Junshu111/junshu-camera/models/README.md

# 外壳与打印模型参考

单位为毫米。STL 用于导入后重新切片；Blender、FreeCAD、STEP 和网格坐标源用于理解、修改。已有网格源不等于全参数化 CAD，改变尺寸后应重新核对内部空间、配合和壁厚。

## 先选择正确版本

| 目录 | 内容 | 如何使用 |
| --- | --- | --- |
| core-20261028 | V27 主壳和共用件、V28 内部件、V29 镜头件、A_down 拨杆；50 个 STL、完整 3MF、Blender 装配、坐标和打印预设 | 原始结构基线，不要求把50对象都装上或全部重印 |
| battery-v31 | 对应48×40×20 mm电池的09盒体和07面盖；源网格、STL、3MF与安装图 | 成套替换基线旧07／09；其他鞋键等按说明复用 |
| usb-c-g2 | 修正方向的30滑盖、31胶粘托架、32后挡，另带原04底盖备用 | 替换基线充电口小件；不要使用已经过时的G1安装图，33键不用于G2 |
| lever-v30 | F1—F3圆盘、T1—T3卡环及试配说明 | 六个是试配候选，不要全部安装或默认选最厚档 |
| hood-n3-v1 | 七件式外置折叠遮光斗，装配源与逐步说明 | 可选附件，实际卡紧、弹性、开合和寿命待打印验证 |
| bottom-clips | 四只底盖连接扣的单独补印盘 | 维修补件，与基线同源，不替代完整机壳 |
| exterior-concept-r01 | FreeCAD可见性修正工程、STEP和重建脚本 | 仅外观概念：125×78×42 mm，无完整内部适配或可打印结构，不是上面106 mm高方盒的替换壳 |

**48×40×20 mm 电池与 G2 充电口采用后续替换件时，原总包的旧07／09与30—33并不是最终组合。** 原版说明保留历史上下文，先按这张替换表选件，再查看各目录说明。

## 文件与检查范围

- 原主壳参考外形125×78×106 mm；与4.3英寸顶部屏幕、Pi3B+、CM2及原控件的尺寸相关。
- 3MF 是原交付的拓竹 X2D / 0.4 mm喷嘴 / PETG Matte 示例，不是所有材料的默认配方。部分含原机器的切片 G-code；先以项目方式打开、检查对象并为自己的打印机重新切片，不直接发送内嵌G-code。
- V30试配例为0.12 mm层高；主结构等示例为0.16 mm。材料、机器、方向或缩水不同，间隙与手感可能不同。
- 来源记录中的切片或几何检查通过，不代表新读者的实物装配、胶接、电池线根余量、供电或长期寿命通过。遇阻先停止该步骤，核对零件版本和实际尺寸。
- Blender装配可能含硬件代理和示意对象；可打印件以相应STL和零件清单为准，不能把装配场景里的每个网格都当作打印件。

从 [core-20261028/原版安装说明.md](core-20261028/原版安装说明.md)理解基础顺序，再按本页替换表和 [battery-v31/安装说明.md](battery-v31/安装说明.md)处理后续电池件。G2当前提供文字选件与干装说明，没有把G1旧图改名冒充G2教程。

所有选入文件的来源、SHA与改动说明见根目录 SOURCE-MANIFEST.json；自有模型和图文用 CC BY 4.0，署名“自制相机项目”。视频制作场景和动画未包含在这里。
