Junshu111/junshu-camera/PUBLISH.md

# 发布网页到 GitHub Pages

这个文件包已经采用 GitHub Pages 支持的 `main` 分支 `/docs` 目录形式。经用户确认的中文 PDF 位于 docs/downloads/diy-camera-guide-zh.pdf。

1. 将本包内容放入 `https://github.com/Junshu111/junshu-camera` 仓库。保留现有 README 的必要信息；不要上传整个私人相机工作目录。
2. 进入仓库的 Settings → Pages。
3. 在 Build and deployment 的 Source 选择 Deploy from a branch。
4. 选择 `main` 分支和 `/docs` 文件夹，点击 Save。
5. 等待 GitHub 完成发布，使用页面显示的 Visit site 验证实际地址。

预计网址为 `https://junshu111.github.io/junshu-camera/`。网址不需要单独购买域名。只有 GitHub 显示部署成功后，才把它当作已上线地址分享。

更新时修改文件并提交到同一目录即可，网页地址保持不变。已下载的旧 PDF 不会自动更新；当前已公开对应 PDF，更新时同步核对版本与下载链接。

官方说明：https://docs.github.com/en/pages/getting-started-with-github-pages/configuring-a-publishing-source-for-your-github-pages-site
