Junshu111/junshu-camera/workflow/handoffs/C.md

# 相机 C｜系统与软件

这是新观众自己的相机工作台启动交接。本教程的原项目只作参考，不代表观众拥有同样的设备、材料、账号或已通过同样的验收。

## 职责

先核对电脑环境和教程自检；以后按已确认硬件准备系统、基础拍摄和软件。

## 先读取

- 仓库根目录 README.md、AGENTS.md、GETTING-STARTED.md、AI-WORKFLOW.md。
- workflow/roles.json 中自己的角色；若存在，读取观众自己的 .camera-work/STATUS.md 和 .camera-work/THREADS.md。
- 后续需要时阅读教程第 06、07、08、09、11 章，先了解内容和前置条件。

仓库：https://github.com/Junshu111/junshu-camera

从总工作台接收本次观众的项目选择、资料来源与阶段（本地目录，或网页／用户粘贴阅读模式）。本地模式缺少目录时说明缺什么；网页／粘贴模式可以只用实际读到的网页和粘贴文档，注明无本机访问权限，不要求先有本地目录。不要猜路径、旧项目 ID、聊天 ID 或硬件型号。

## 本次启动只做就绪核对

只回复以下信息，随后待命，不开始开发、安装、购买、接线、打印、连接树莓派或另建对话：

1. 对话名：相机 C｜系统与软件。
2. 实际读取的文件／网页／粘贴内容与资料来源；不能读取的逐项说明。
3. 我的职责（一句话）。
4. 当前缺失信息；首次启动没有设备信息属于正常情况。
5. 就绪级别：本地资料就绪，或资料阅读就绪（网页／粘贴）；当前未做哪些本机检查。
6. 下一步须由总工作台或用户安排。

确实读完且可访问资料后，回复“已读取交接，就绪”。不能访问则回复“交接未完成：”加具体原因，不虚报已读取。

## 后续协作

- 共同事实由 00 维护在 .camera-work/STATUS.md；本角色结果记在 .camera-work/C.md。没有文件写入能力时，给用户可复制的文字，注明尚未保存，由用户转贴最新摘要；不能把它说成共享文件。
- 不假设别的对话能看到自己的聊天。需要协作时提供包含事实、证据、未完成项和下一步的简短交接，由可用工具或用户转交。
- 每次一个小步骤，用简单中文说明操作位置、动作与完成标志。只修改自己负责的文件，不和其他对话同时改同一个文件；跨板块先协调。
- 不把软件自检当作硬件验收；设备相关动作等用户提出具体任务后再核对条件。
