Junshu111/junshu-camera/models/lever-v30/原版试配说明.md

# V30 拨杆空程校准包

制作完成于 2026-10-28；目录日期保留本轮开始日期。基于已能正常下拨的临时 01 **A_down** 盒架和圆盘，保留现有开关、外拨杆、主壳及止挡位置。本轮只打印 6 个可替换小件，同一盘完成，每组每次只安装其中一件。

**打印入口：[01_X2D_PETG_Matte_V30_Lever_Fit_Calibration.3mf](01_X2D_PETG_Matte_V30_Lever_Fit_Calibration.3mf)**

[六件对照与测试顺序图](images/V30-六件标记与测试顺序.png) · [实际顶层刀路及刻线核对](images/actual-top-layer-paths.png)

## 两组分别解决什么

你确认「内部圆盘跟着转，但金属开关杆暂时不动」，因此主要空程在 **26 圆盘叉口与金属开关杆的接触处**。F 组用于缩小这处空程；T 组用于调整转轴前后窜动，两组分开测试，便于知道哪个改动有效。

照片红圈的两块白色凸台属于 **25 盒架的固定止挡**。它们不直接接触金属杆。计算显示，同时沿照片向下移动 0.2 mm，会让下拨终点约提前 1°，回位端反而多约 0.8° 余程，因此这次保留已验证可触发的止挡，改真正拾取金属杆的叉口接触面。

## 实体标记与档位

| 编号 | 形状 | 简单标记 | 改动 |
| --- | --- | --- | --- |
| T1 | U 形卡环，28 号件 | 1 条短刻线 | 总厚 1.40 mm，接近原卡环，作为参照 |
| T2 | U 形卡环，28 号件 | 2 条短刻线 | 总厚 1.52 mm |
| T3 | U 形卡环，28 号件 | 3 条短刻线 | 总厚 1.64 mm |
| F1 | 带叉口的圆盘，26 号件 | 1 条短刻线 | 下叉内接触面向槽内推进 0.10 mm，槽宽 7.30 mm |
| F2 | 带叉口的圆盘，26 号件 | 2 条短刻线 | 下叉内接触面向槽内推进 0.15 mm，槽宽 7.25 mm |
| F3 | 带叉口的圆盘，26 号件 | 3 条短刻线 | 下叉内接触面向槽内推进 0.20 mm，槽宽 7.20 mm |

T 组刻线在一只开口腿上；F 组在轴套平面上，靠方孔外侧。都是浅刻，不加凸起。图中各零件从标记面展示；与装机照片可能左右相反，实际安装继续沿用原方向。F 组的上叉、方孔、转轴配合和外轮廓均保持原形，圆盘整组不会移位或反向。

## 打印

已用本机 Bambu Studio 按 **拓竹 X2D、0.4 mm 喷嘴、Bambu PETG Matte、纹理 PEI 板**实际切片并重新打开。单盘六件估计 **约 41 分钟、6.46 g**，本次切片支撑耗料为 **0 g**。保留工程摆向、100% 比例和内置设置即可。

- 层高 **0.12 mm**，首层 0.20 mm；4 层墙、20% gyroid、外侧 brim 5 mm。
- 三只卡环的 G-code 顶层高度已核对，分别为 **1.40 / 1.52 / 1.64 mm**，不会被切成同一厚度。
- 成功使用过的支撑参数仍嵌在工程中：普通自动／紧贴／35°，Z 0.24 / 0.24、XY 0.35、界面 3 / 2 层及 0.5 mm 间距。保持“开启支撑”即可，当前摆放并未实际生成支撑。
- 两组均平放打印。圆盘内方孔有约 8.34 mm 的最长桥接刀路线段，这个数值不是保证桥接质量；取件后检查孔内有无明显垂料再装方轴。关键接触面和刻线均不靠拆支撑得到。
- 卡环有 brim，取件后只清除薄薄的贴床外缘，别把 U 形两腿削薄或剪断。
- 在打印板中 T1 / T2 / T3 位于一排，F1 / F2 / F3 位于另一排；每排按 1 → 3 排列。对象名也含编号与尺寸，取下后按刻线识别。

## 怎么测试

先断开电池供电，保留原来已能正常下拨的 **A25 盒架、112-B1 开关和原安装方向**。本包不是给 B 上拨诊断盒架使用的，也不需要把开关本体翻转。两组试样不是同时全装入。

1. **先测 F 组。** 保持现在的 U 形卡环不变，依次用 F1、F2、F3 替换原圆盘；每次重新装好原外拨杆、衬套和卡环。
2. 轻拨几次，观察圆盘和金属杆是否更早一起动作，松手能否自行完全回位。静止时不能持续压着金属杆，也不能需要手推才能回位。若某档已经卡住，换回较松一档，不强拉。
3. 选择“虚位更小、拨动顺、自动回位完整”的 F 档。F3最紧，但不保证最合适。F 档之间只差 0.05 mm，打印误差可能让相邻两档手感接近；如接近，反馈为“差不多”即可。
4. **固定刚选好的 F，再测 T 组。** 依次换 T1、T2、T3，观察转轴前后窜动是否变少，同时确认转动没有变涩、回弹仍完整。卡环只装一只，不叠加。
5. 最后对选中的组合试拍，确认静止不误触发、一次下拨能正常拍摄、松手能复位。新件尚未实物试装，计算结果不能代替这一步。

建议直接这样反馈：

> F2 + T2：虚位明显减小；拨动顺；松手全部回位；正常触发。F3 会卡／T3 太紧。

如果三档之间差不多，也请说是哪一组。保留原圆盘和原卡环作为对照，不要削原止挡来补偿。

## 复用与检查范围

保留现有 **A25 盒架、27 外柄 B 或 C、29 轴套、112-B1 开关及原螺母、盒架锁件、主壳**。这里只用一个 F 和一个 T，其他作为尺寸对照件。已经打印好的 V28、V29 镜头和内部固定件继续使用。

六件都已做单连通／闭合网格、原接口保持、A 全行程静态避让、B/C 外柄、已知开关本体、V27/V28/V29 场景与规划线束检查；导出 3MF 与源 STL 的网格、摆向和比例复核通过。族图金属杆代理中，三档在名义休止位均无预压，接触逐档提前，原固定止挡接管角保持。但实际金属杆截面、开关自然回位角、PETG 打印公差、力和磨损未测，尤其不能保证 F3 的实物间隙。

最终 3MF SHA256：`b3f65afaebf328b8c55c4b22fd70b07c8084ed2d6abcf7248b7a80073f101cd6`。本轮没有改主壳、旧制造工程、树莓派或打印机，也没有删除任何文件。
