Junshu111/junshu-camera/LICENSES/README.md

# 许可范围

Copyright © 2026 自制相机项目。

- 本项目自有的软件源码、脚本和测试：仓库根目录 [MIT License](../LICENSE)。允许使用、修改和再分发，保留版权与许可声明。
- 本项目自有的三维模型、网格、打印工程、图示、教程文字和工作流模板：[CC BY 4.0](CC-BY-4.0.txt)。允许分享和改作，包括商业用途；署名“自制相机项目”，链接原仓库及许可，并说明修改。
- 软件内 New Cam 图形素材随图文采用 CC BY 4.0。使用素材不代表原项目维护者为衍生项目背书。
- 第三方文件按各自原有许可：二维码库 Nayuki QR Code generator 的 MIT 声明保留在软件 vendor 目录；字体 Inter 和 Noto Sans SC 的原许可保留在 docs/assets/fonts/。
- 运行依赖如 PyQt5、Pillow、Picamera2、libcamera、gpiod、系统服务及建模／切片软件没有随本仓库重新授权，使用时遵守它们各自的许可。

模型和源代码以现状提供。资料中的数字检查、特定设备使用反馈与读者自己的装配、用电、打印和长期可靠性检查分开记录。

许可来源：[MIT 官方文本](https://opensource.org/license/mit)、[CC BY 4.0 官方许可](https://creativecommons.org/licenses/by/4.0/)。
