Junshu111/junshu-camera/project-reference/requirements/README.md

# 原项目需求与决策参考

本目录公开原相机的PRD、问答和决策记录，帮助理解如何从目标形成制作步骤。它们是历史设计记录，不是观众已经确认的需求，也不表示其中每项功能已经实现。

当前技术参考以根目录 RELEASE-CONTENTS.md、software/README.md 和 models/README.md 为入口；是否通过验收以对应版本的证据和观众自己的实测为准。PRD里的静态界面只说明设计方向。

公开副本只调整本机绝对路径和交接链接，原始本地文档保留。观众自己的目标、预算和进度由相机00及A维护，避免直接照搬原样机的全部需求。
