Junshu111/junshu-camera/models/usb-c-g2/README.md

# G2 充电口方向修正版

先用当前目录的3MF和stl/内文件。30为配套滑盖、31为胶粘托架、32为加宽U形后挡；04底盖仅备用，已有正确底盖可复用，不必重印。不使用基线旧31、旧32和33固定键，也不使用G1安装图的方向。

先正常关机并断开电源，在未装电池、未通电条件下核对实际Type-C母口尺寸、朝向、尾线空间和底盖孔位；先干装、确认方向与线根无挤压，再按适合实际材料的胶接方法固定。胶不能进入接口或接触电池、导线裸露端。

原G2数字刚性装配和切片已核对；实物干装、真实线通过和胶接强度仍需用户自己的验证。source/保留修正后的装配源；本次公开整理没有改变网格。
