Junshu111/junshu-camera/project-reference/requirements/decisions.md

# A 板块决策记录

当前 PRD：v0.1.4；更新日期：2026-10-13（Asia/Shanghai）。

原则：用户最新确认优先；初稿建议、工作表示例、概念图和其他板块建议，不自动成为用户决定。确认状态、优先级和验证状态分别记录。新增条目不重排已有编号。

## 1. 既有确认决定

来源统一为原项目制作者于 2026-10-13 的最新消息；保留关键原话以便核对。

| 决定编号 | 确认内容与来源摘录 | 对应要求 | 影响 |
| --- | --- | --- | --- |
| A-DEC-001 | “先做一台自己能带出门，拍街景、旅行和生活记录的完整相机”。 | A-REQ-001、002 | A1 不重复询问用途；产品目标以日常完整相机为准。 |
| A-DEC-002 | 对“2×是否同时裁切取景和最终保存照片”回答“是的”。 | A-REQ-009 | 预览与保存采用一致的裁切范围；当时未决定是否额外留原图；本轮Q11已明确不额外保存未裁切独立照片，RAW像素规则现由Q38记录为后续全幅加裁切信息；当前不执行RAW拍摄。 |
| A-DEC-003 | “大部分的操作我希望通过触屏来完成”。 | A-REQ-004 | 手动参数的入口优先讨论触屏；不默认需要实体旋钮。 |
| A-DEC-004 | “保留至少两个实体按键”，分别是执行拍照的快门键和用于开关机的开机键。 | A-REQ-005、006、007 | 至少两个键，不锁定恰好两个；本轮Q23和Q29进一步确认电源动作及拉杆形态，详见新增决定。 |
| A-DEC-005 | “前期仅通过micro sd即可”，并希望简单操作。 | A-REQ-010 | 不加入前期无线或 USB 直连导出要求；存照布局及安全取卡流程需验证。 |
| A-DEC-006 | 体积、重量、续航“初稿先把这个问题留着”，看完后再回复，并要求再提问一次。 | A5，A-OPEN-006 | 原定读稿后再问；本轮Q25至28已回答，提醒完成，数值仍待实测。 |
| A-DEC-007 | 本对话只负责 A 产品定义与 PRD；其他问题整理为供总工作台分配的任务。 | 协作边界 | 只维护 A-PRD；不实现相机软件、接线、采购或结构。 |
| A-DEC-008 | “除了本身的工作文件之外，再给我一份容易阅读的PDF”。 | 交付要求 | 保存 PRD.md、decisions.md、handoff.md，并生成 PRD-阅读版.pdf。 |
| A-DEC-009 | 最初要求每轮只讨论一个关键问题，区分用户确认、建议和待实测，按 A1 至 A8 完善。 | 初始工作方式 | v0.1 按此执行；提问节奏现由 A-DEC-010 调整，状态区分继续沿用。 |
| A-DEC-010 | 最新原话：“我大概看了，我还是希望在这个对话框里，把问题都统一给我，我一条条按顺序来回答。” | 最新工作方式 | 一次在对话展示完整清单，按 A1 至 A8 连续编号，允许逐条或分批回答；初步阅读不视为批准全部草案。 |

## 2. 历史确认的延续与冲突处理

历史来源：2026-10-13 PRD 工作表中的“已经确定的内容”，以及截至 2026-10-12 的迁移包 handoff、ui-and-design 和 decision-log。这里延续既有确认，没有将其标成用户本轮重新确认。

| 记录编号 | 历史内容 | 当前处理 |
| --- | --- | --- |
| A-HIST-001 | 单摄、当前阶段拍照片，不开发录像。 | 延续 A-REQ-003。 |
| A-HIST-002 | 顶部屏幕；左手托底、右手快门；胸前或略低位置持机。 | 延续 A-REQ-011、012；姿势与结构仍需实测。 |
| A-HIST-003 | 主要拍竖幅；横拍上方预览、下方控制。 | 延续 A-REQ-013、014；比例与安装方向未锁定。 |
| A-HIST-004 | 1×、2×、更多入口；2×曾作为数字裁切候选。 | 延续 A-REQ-008；最新 A-DEC-002 正式确认裁切用于取景与保存。 |
| A-HIST-005 | 快门拉杆及三只旋钮的外观偏好。 | 保留历史参考；结合 A-DEC-003、004，不列为首台必需。本轮Q29选择拉杆；三只旋钮仍不是必需，不因附图自动加入。 |
| A-HIST-006 | 喜欢 C-P1、D-P2 两个方向，未最终选定。 | 保留为 E 的外观参考，不冻结机壳样式和尺寸。 |
| A-HIST-007 | Pi 3B+、CM2、触摸屏和 PB721 已有；系统、屏幕与触摸有基础测试。 | 测试起点；不是最终硬件选型，也不是整机已通过证明。 |

旧候选项按本轮答案更新：默认自动曝光和默认自动白平衡不直接采用，改为恢复上次模式；手动参数、回显、相机内回看和异常反馈已由Q14、20、21、36确认。A-CAND-001/002由A-REQ-025/026替代其默认假设；A-CAND-003至006转入A-REQ-027、034至039、051。LUT留后续；无线导出继续不纳入前期要求。候选编号保留作历史追踪，不另维护重复需求正文。

## 3. v0.1.2保存的36项回答

以下36条来源均为本对话本批用户回答，日期2026-10-13。每条保留原话，不将用户提出的硬件候选参数当作已经实测。

| 决定编号 | 原题 | 用户原话 | 记录状态 | 关联需求 |
| --- | --- | --- | --- | --- |
| A-DEC-011 | Q1 | 需要时再开机。 | 已确认 | A-REQ-015 |
| A-DEC-012 | Q2 | 手持为主，可以选择背带或放包里 | 已确认 | A-REQ-016 |
| A-DEC-013 | Q3 | 静止街景，户外帮朋友拍照、人物照片为主。 | 已确认 | A-REQ-017 |
| A-DEC-014 | Q4 | 白天户外，紧接着室内。夜晚暂时不考虑，考虑传感器大小还是太小了 | 已确认使用取舍；未将原因写成实测结论 | A-REQ-018 |
| A-DEC-015 | Q5 | 桌上的食物、近距离人像、对街建筑。这些都是需要的。 | 已确认场景；具体距离待样片 | A-REQ-019 |
| A-DEC-016 | Q6 | 手机查看、电脑编辑 | 已确认 | A-REQ-020 |
| A-DEC-017 | Q7 | 3:4、1:1、16:9、9:16 | 已确认 | A-REQ-013、A-REQ-021 |
| A-DEC-018 | Q8 | 自然还原。后期成熟后再制作lut风格 | 已确认；LUT后续 | A-REQ-022、A-REQ-053 |
| A-DEC-019 | Q9 | 色彩、清晰度更重要 | 已确认；样片待评价 | A-REQ-022 |
| A-DEC-020 | Q10 | JPEG+RAW，JPEG、RAW。有三个选择 | 已确认需求；能力待验证 | A-REQ-023 |
| A-DEC-021 | Q11 | 不需要额外保留未裁切。给用户的体验是，所见即所得。如果用户选择了2x则出来就是裁切的，如果选择1x，则是不裁切的。 | 已确认目标；RAW与比例规则需细化 | A-REQ-009、A-REQ-024 |
| A-DEC-022 | Q12 | 恢复上次的模式 | 已确认 | A-REQ-025 |
| A-DEC-023 | Q13 | 恢复上次的模式。如果用户设置了自动白平衡，开机后就是自动白平衡，如果是自定义，则自定义。 | 已确认 | A-REQ-026 |
| A-DEC-024 | Q14 | 曝光补偿、快门、ISO／增益、白平衡，这些都需要。 | 已确认需求；范围待核实 | A-REQ-027 |
| A-DEC-025 | Q15 | 是的，需要。 | 已确认需要限制；阈值待定 | A-REQ-028 |
| A-DEC-026 | Q16 | 按一次拍一张。暂时不考虑连拍 | 已确认 | A-REQ-006 |
| A-DEC-027 | Q17 | 网格（暂不做）、直方图（必须）、曝光锁定（必须）、自拍延时（必须） | 后三项明确P0；网格首台不做 | A-REQ-029、A-REQ-030、A-REQ-031、A-REQ-055 |
| A-DEC-028 | Q18 | 再开机，倍率、曝光、白平衡、屏幕亮度，这些都要保留。 | 已确认 | A-REQ-032 |
| A-DEC-029 | Q19 | 是的 | 已确认：启动后直接取景 | A-REQ-033 |
| A-DEC-030 | Q20 | 最好可以选择。默认是短暂显示照片3s再恢复。这个需要在设置菜单里，给用户选择。 | 已确认；其他选项待细化 | A-REQ-034 |
| A-DEC-031 | Q21 | 需要。用户可以触屏选择观看当前张，也可以选择同时看到多张。并且触屏可以进行放大缩小（双手指），屏幕也有多选择功能，多选择后，可以一次性删除多张照片。默认删除按键，是用户点击预览单张照片时，会在触屏里出现。如果用户在同时观看多张照片，只有多选按钮。 | 已确认；双格式分组与删除规则需细化 | A-REQ-035、A-REQ-036、A-REQ-037 |
| A-DEC-032 | Q22 | 提示忙碌。 | 已确认；不登记排队拍摄 | A-REQ-038 |
| A-DEC-033 | Q23 | 双击短按后在屏幕确认。长按3s也可以直接关机。不过关机时，如果正在保持照片，则需要等保存完成后，再关机。 | 已确认；按上下文将“保持照片”理解为“保存照片” | A-REQ-007、A-REQ-039 |
| A-DEC-034 | Q24 | 两则都需要。 | 已确认：Mac和Windows | A-REQ-010 |
| A-DEC-035 | Q25 | 我希望内置电池。暂时测试时使用充电宝，当机子测试到一定程度后，开始做结构时，再考虑电池位置。 | 内置目标已确认；测试电源与结构阶段区分 | A-REQ-041 |
| A-DEC-036 | Q26 | 目前有一些concept图片（附图）。不过这需要完成基础功能测试，到结构设计时再最后确认。 | 参考图已提供；尺寸与结构待验证 | A-REQ-043 |
| A-DEC-037 | Q27 | 待称重和握持比较 | 已回答：待实测 | A-REQ-044 |
| A-DEC-038 | Q28 | 目前考虑电池大小是5v3a的2500毫安电池。内置在相机里。实际续航待测试。 | 候选规格；容量单位及基准电压待核实；续航待测 | A-REQ-042、A-REQ-045 |
| A-DEC-039 | Q29 | 我希望是拉杆形态。如果设计成熟，我希望把录制视频和拍照分开。拉杆形态是拍照，按键是录制视频。不过暂时先不考虑视频录制。 | 拉杆已确认；视频控制后续 | A-REQ-003、A-REQ-005、A-REQ-006、A-REQ-046、A-REQ-054 |
| A-DEC-040 | Q30 | 是的。希望不要拆机壳取卡，只打开卡槽盖就能取出 microSD | 已确认 | A-REQ-040 |
| A-DEC-041 | Q31 | 零件没有上线。不过大部分打算使用拓竹的3D打印机（X2D）来完成大部分零件，元器件则可以网上或者华强北购买。 | 按上下文记录为未设零件预算上限；型号原样保留待核实；时间未指定 | A-REQ-047 |
| A-DEC-042 | Q33 | 待测试。当然越快越好。 | 已回答：目标待实测 | A-REQ-048 |
| A-DEC-043 | Q34 | 要能抓瞬间 | 体验目标已确认；时间待实测 | A-REQ-049 |
| A-DEC-044 | Q35 | 没有概念，是不是要取决于读卡速度？这个可以通过测试后再研究。 | 已回答：待实测；分解编码与写卡等环节 | A-REQ-050 |
| A-DEC-045 | Q36 | 可以通过声音来提示。保存成功和保存失败分别有对应的音效。并且画面也需要提示对应的异常状态。 | 已确认 | A-REQ-051 |
| A-DEC-046 | Q37 | 应该先检查开机、拍照、保存、导出和关机，这些基本功能，然后才外出拍照测试。 | 已确认验收顺序 | A-REQ-052 |

## 4. v0.1.3新增的8项回答

以下为本对话最新回答，日期2026-10-13。Q32确认首台必做范围，Q38进一步给出实际RAW拍摄延后的具体例外；两项结合记录，不把一般范围确认覆盖具体延期。

| 决定编号 | 原题 | 用户原话 | 记录状态 | 关联需求 |
| --- | --- | --- | --- | --- |
| A-DEC-047 | Q32 | 是的 | 已确认其余当前功能为首台P0；Q38的RAW实际拍摄延后作为明确例外。 | 当前首台范围；A-REQ-023、053至057、059 |
| A-DEC-048 | Q38 | 我希望是后一种。但是我觉得这有点难度。我的决定是，UI界面保留raw的选择，但是现阶段不执行raw的拍摄功能，还是以jpg为主。只是提供这个选择，但是用户选择后，会显示raw暂不支持。 | 首台仅实际拍JPEG；保留RAW相关提示入口。后续偏好全幅RAW加裁切信息，兼容性待后续验证。 | A-REQ-009、023、056、057 |
| A-DEC-049 | Q39 | 是的 | 已确认1×仍允许所选比例裁切。 | A-REQ-009、021、024 |
| A-DEC-050 | Q40 | 曝光ev为0，白平衡为自动，倍率是1x，比例是9:16（竖屏拍摄），保存格式默认jpg | EV 0、自动WB、1×、9:16、JPEG五项已确认。曝光模式自动/手动尚未说明，新增45；不将本题标为漏答。 | A-REQ-021、025、026、058 |
| A-DEC-051 | Q41 | 分别是3s，5s，10s | 已确认三个选项：3s、5s、10s。默认和取消等细节未决定。 | A-REQ-031 |
| A-DEC-052 | Q42 | 是的，预览时只展示jpeg，删除时两个文件同时删除。删除时仅提示「是否确认删除」即可，无需提示raw删除这件事。 | 当前JPEG删除先确认“是否确认删除”；双格式逻辑照片、JPEG预览与配对删除规则留给后续RAW。 | A-REQ-037、059、060 |
| A-DEC-053 | Q43 | 如果出现保存失败，则停止关机，并提示用户报错。 | 已确认取消本次关机，保持开机并报错。 | A-REQ-039、051 |
| A-DEC-054 | Q44 | 需要关闭回显，秒数可以设置3s和10s两个选择。 | 已确认关闭、3s、10s三个选项；默认继续为3s。 | A-REQ-034 |

A的交互建议：RAW和JPEG+RAW入口点击后提示“raw暂不支持”，保持JPEG为有效格式且清楚显示。入口和不执行RAW由用户确认；有效格式如何显示由C细化，不把建议当作用户新增原话。未创建或测试RAW文件。

## 5. v0.1.4新增确认

本对话2026-10-13最新两条用户消息；原话完整保留。触屏拍照是新增需求，不从概念图倒推用户已确认。

| 决定编号 | 原题或来源 | 用户原话 | 记录状态 | 关联需求 |
| --- | --- | --- | --- | --- |
| A-DEC-055 | Q45 | 是的。自动曝光 | 首次自动曝光已确认；EV 0沿用Q40，后续仍恢复上次模式。 | A-REQ-025、058 |
| A-DEC-056 | 用户主动新增 | 我刚想到，拍照功能在触摸屏里也需要有。可以在触摸屏上直接点击拍照。 | 首台P0；触屏拍照与实体拉杆并存，共用既有拍摄规则；布局由C细化。 | A-REQ-006、038、061 |

Q45关闭；首次自动曝光由建议转为确认。触屏入口不替代实体拉杆；同一拍摄功能已有的自拍、忙碌、保存及回显规则均适用于两种入口。A只记录要求，不启动实现。

## 6. 当前开放决定与提醒

| 编号 | 最新状态 | 下一步与影响 |
| --- | --- | --- |
| A-OPEN-001 | Q1已确认需要时开机。 | 关闭使用习惯问题；启动数值转A-VER-002。 |
| A-OPEN-002 | 白天户外、室内，静止街景和朋友人像；食物、近人像、对街建筑均需要。 | 场景已明确；实际距离与清晰度转A-VER-001。 |
| A-OPEN-003 | 四比例、1×比例裁切、2×范围和JPEG阶段明确；后续RAW全幅加裁切信息。 | 38/39已回答；RAW真实拍摄延后，不阻塞当前JPEG验证；输出尺寸仍看样片。 |
| A-OPEN-004 | 首次自动曝光、EV 0、自动WB、1×、9:16、JPEG；自拍选项及触屏/拉杆双拍照入口明确。 | Q45已答，首次默认关闭；锁定、直方图、自拍/回显细节后续统一提问，控制范围由B测。 |
| A-OPEN-005 | 回显关闭/3s/10s、删除确认、后续双格式配对、失败取消关机已确认。 | 42至44不再待答；双格式验证为后续，当前JPEG图库和关机先验证。 |
| A-OPEN-006 | 内置电池目标已明确；候选电源参数、尺寸、重量、续航未冻结。 | D核电池标注，E/B/D实测；不重复当作用户漏答。 |
| A-OPEN-007 | Mac、Windows与卡槽盖取卡已明确；microSD共卡、分区和读取方案未定。 | 由总工作台安排B/C/D/E验证；不要求用户预选文件系统。 |
| A-OPEN-008 | Q32已确认其余当前功能首台P0；Q38明确实际RAW与双格式拍摄延后。 | 关闭A6范围问题；占位提示仍P0，JPEG阶段先行，当前不做项继续保留。 |
| A-OPEN-009 | 抓瞬间已明确，启动与再拍时间待测；声音和屏幕异常反馈已明确。 | 分项性能、音频、可靠性验证；之后确定数值目标。 |

A-REM-001：2026-10-13已在清单第25至28题再次提问，并收到本轮回答，提醒状态为**完成**。体积/重量/续航目标仍待实测，不把提醒完成当作指标完成。已有答案、原话和来源见questions.md。

## 7. 版本与变更

| 版本 | 日期 | 本轮变化 | 确认与验证状态 |
| --- | --- | --- | --- |
| 聊天初稿 | 2026-10-13 | 形成容易阅读的用途、流程、功能和验收方向；当时未保存为正式文件。 | 多数功能是本对话建议。 |
| v0.1 | 2026-10-13 | 首次保存 A 板块工作文件；整合用途、2×、触屏、两个实体键和 microSD 确认；分开历史偏好、建议与验证任务；生成阅读版 PDF。 | 待制作者审阅；A1-Q01 待回答；未完成 A1 至 A8，未开展整机验证。 |
| v0.1.1 | 2026-10-13 | 按最新要求新增 questions.md，完整展示 37 项问题，更新讨论方式与便携提醒；同步阅读版 PDF。 | 产品需求编号与内容不变；全部问题待回答，A1 至 A8 未完成。 |
| v0.1.2 | 2026-10-13 | 录入原37题中的36项回答；保留原14个需求号并追加至55项；新增验收和验证任务；记录3项明确P0、8项关键待答及附图参考；更新阅读版。 | 未获A6完整范围确认；RAW与若干规则待细化；未新增实机验证，仍非v1.0基线。 |
| v0.1.3 | 2026-10-13 | 保存Q32及Q38至44的8项回答；确认当前功能P0、实际RAW延后；补1×比例裁切、首次默认、自拍、删除、失败关机和回显；60条需求、26项验收、9项待分配验证任务；同步PDF。 | 第45题仅补首次曝光模式；性能/控制/供电等仍待测，尚非最终基线，未新增硬件验证。 |
| v0.1.4 | 2026-10-13 | 首次自动曝光获确认；新增触屏拍照P0并保留拉杆，统一自拍/忙碌/保存/回显规则；61条需求、27项验收、10项待分配验证；同步PDF。 | 1至45题均已回答，详细交互与实测仍待完善；未实施相机功能或新增硬件测试。 |

后续每轮记录：用户原话或来源、日期、对应编号、变更原因、对拍摄流程/软硬件/结构/验收的影响。其他板块提议先记录为变更建议，由制作者确认后更新正式需求。
