Junshu111/junshu-camera/project-reference/requirements/questions.md

# A 板块统一问题与回答记录

清单版本：Q-v0.4；配套PRD：v0.1.4；日期：2026-10-13（Asia/Shanghai）。

## 当前状态

- 第1至45题全部已回答；本轮另收到用户主动新增的触屏拍照要求，单独记录，不占用下一题编号。
- Q32确认其余当前功能首台P0；Q38明确实际RAW拍摄延后，仅保留提示入口。
- Q45已确认首次自动曝光，EV 0沿用Q40；本轮已发出问题无待答项，详细交互和实测目标仍需完善。
- 数值暂缺、待样片或待测试属于已回答的“待实测决定”，不标成用户漏答。
- A-REM-001便携再次提问与回答已完成；尺寸、重量、续航依然待测。
- 所有答案来源为本对话，日期2026-10-13；概念图不作为功能或尺寸确认。
- 细节待完善清单集中保存在下文，之后按A1至A8统一在本对话提问。

## 本轮原题答案

### 1. A1-Q01

问题：出门时希望相机一直开机、需要时再开机，还是两种都常用？

> 用户原话：需要时再开机。

状态：已确认。

关联：A-REQ-015。

### 2. A1-Q02

问题：平时主要怎样携带：手持、挂背带，还是放包里？

> 用户原话：手持为主，可以选择背带或放包里

状态：已确认。

关联：A-REQ-016。

### 3. A1-Q03

问题：常拍静止街景，还是走动的人、宠物和转瞬即逝的画面？

> 用户原话：静止街景，户外帮朋友拍照、人物照片为主。

状态：已确认。

关联：A-REQ-017。

### 4. A1-Q04

问题：主要在哪些光线下拍：白天户外、室内、夜晚？可以按常用程度排序。

> 用户原话：白天户外，紧接着室内。夜晚暂时不考虑，考虑传感器大小还是太小了

状态：已确认使用取舍；未将原因写成实测结论。

关联：A-REQ-018。

### 5. A1-Q05

问题：经常拍的主体距离大概多远？可以用“桌上的食物、近距离人像、对街建筑”等例子描述。

> 用户原话：桌上的食物、近距离人像、对街建筑。这些都是需要的。

状态：已确认场景；具体距离待样片。

关联：A-REQ-019。

### 6. A2-Q01

问题：照片主要用来手机查看、电脑编辑、发社交平台，还是打印？

> 用户原话：手机查看、电脑编辑

状态：已确认。

关联：A-REQ-020。

### 7. A2-Q02

问题：希望有哪些照片比例？例如竖幅 2:3、3:4、1:1，以及相应横幅；可以多选。

> 用户原话：3:4、1:1、16:9、9:16

状态：已确认。

关联：A-REQ-013、A-REQ-021。

### 8. A2-Q03

问题：默认照片希望自然还原，还是带某种固定色调或风格？

> 用户原话：自然还原。后期成熟后再制作lut风格

状态：已确认；LUT后续。

关联：A-REQ-022、A-REQ-053。

### 9. A2-Q04

问题：画质最在意哪几项：清晰度、色彩、肤色、暗部、高光还是噪点？

> 用户原话：色彩、清晰度更重要

状态：已确认；样片待评价。

关联：A-REQ-022。

### 10. A2-Q05

问题：JPEG 是否够用，还是希望同时保存 RAW？RAW 作为需求意向记录，支持情况待核实。

> 用户原话：JPEG+RAW，JPEG、RAW。有三个选择

状态：三入口保留；最新Q38已将实际RAW和双格式拍摄延后。

关联：A-REQ-023、057。

### 11. A2-Q06

问题：2×拍摄时，除了已确认的裁切照片，是否还要额外保存未裁切原图？

> 用户原话：不需要额外保留未裁切。给用户的体验是，所见即所得。如果用户选择了2x则出来就是裁切的，如果选择1x，则是不裁切的。

状态：目标确认；Q39明确1×允许比例裁切，Q38明确后续RAW偏好与当前延期。

关联：A-REQ-009、A-REQ-024。

### 12. A3-Q01

问题：开机后的曝光模式希望默认自动，还是恢复上次使用的模式？

> 用户原话：恢复上次的模式

状态：已确认。

关联：A-REQ-025。

### 13. A3-Q02

问题：白平衡希望默认自动，还是恢复上次设置？

> 用户原话：恢复上次的模式。如果用户设置了自动白平衡，开机后就是自动白平衡，如果是自定义，则自定义。

状态：已确认。

关联：A-REQ-026。

### 14. A3-Q03

问题：希望在触屏上手动调哪些参数：曝光补偿、快门、ISO/增益、白平衡，或其他？实际可调范围待核实。

> 用户原话：曝光补偿、快门、ISO／增益、白平衡，这些都需要。

状态：已确认需求；范围待核实。

关联：A-REQ-027。

### 15. A3-Q04

问题：自动曝光时，是否需要限制最高 ISO 或最慢快门？可以先写需要，数值后定。

> 用户原话：是的，需要。

状态：已确认需要限制；阈值待定。

关联：A-REQ-028。

### 16. A3-Q05

问题：快门只需要按一次拍一张，还是希望按住连拍？

> 用户原话：按一次拍一张。暂时不考虑连拍

状态：已确认。

关联：A-REQ-006。

### 17. A3-Q06

问题：网格、直方图、曝光锁定、自拍延时中，哪些希望加入？可以逐项标“必须、可选、暂不做”。

> 用户原话：网格（暂不做）、直方图（必须）、曝光锁定（必须）、自拍延时（必须）

状态：后三项明确P0；网格首台不做。

关联：A-REQ-029、A-REQ-030、A-REQ-031、A-REQ-055。

### 18. A3-Q07

问题：关机再开机后，希望保留哪些设置？例如倍率、曝光、白平衡、屏幕亮度。

> 用户原话：再开机，倍率、曝光、白平衡、屏幕亮度，这些都要保留。

状态：已确认。

关联：A-REQ-032。

### 19. A4-Q01

问题：是否希望开机完成后直接进入取景界面？

> 用户原话：是的

状态：已确认：启动后直接取景。

关联：A-REQ-033。

### 20. A4-Q02

问题：拍完一张后，希望立即恢复取景、短暂显示照片再恢复，还是由你手动返回？

> 用户原话：最好可以选择。默认是短暂显示照片3s再恢复。这个需要在设置菜单里，给用户选择。

状态：已确认；Q44已补关闭/3s/10s选项。

关联：A-REQ-034。

### 21. A4-Q03

问题：相机内回看希望做到哪一步：不需要、只看上一张、浏览所有照片？需要放大或删除也可以注明。

> 用户原话：需要。用户可以触屏选择观看当前张，也可以选择同时看到多张。并且触屏可以进行放大缩小（双手指），屏幕也有多选择功能，多选择后，可以一次性删除多张照片。默认删除按键，是用户点击预览单张照片时，会在触屏里出现。如果用户在同时观看多张照片，只有多选按钮。

状态：已确认；Q42补删除确认及后续双格式配对规则。

关联：A-REQ-035、A-REQ-036、A-REQ-037。

### 22. A4-Q04

问题：上一张还在保存时，再按快门应提示“忙碌”并暂不拍，还是记住这次按压、随后继续拍？

> 用户原话：提示忙碌。

状态：已确认；不登记排队拍摄。

关联：A-REQ-038。

### 23. A4-Q05

问题：关机希望怎样操作：长按电源键直接正常关机，还是短按后在屏幕确认？其他方式也可以说明。

> 用户原话：双击短按后在屏幕确认。长按3s也可以直接关机。不过关机时，如果正在保持照片，则需要等保存完成后，再关机。

状态：已确认；按上下文将“保持照片”理解为“保存照片”。

关联：A-REQ-007、A-REQ-039。

### 24. A4-Q06

问题：microSD 导出的照片主要需要在哪种电脑上读取：Mac、Windows，还是两者都要？

> 用户原话：两则都需要。

状态：已确认：Mac和Windows。

关联：A-REQ-010。

### 25. A5-Q01

问题：出门是否接受外置充电宝和连接线，还是希望电源全部装进机身？

> 用户原话：我希望内置电池。暂时测试时使用充电宝，当机子测试到一定程度后，开始做结构时，再考虑电池位置。

状态：内置目标已确认；测试电源与结构阶段区分。

关联：A-REQ-041。

### 26. A5-Q02

问题：体积希望接近哪台熟悉的相机或物件？没有参照可以先写“看实物后定”。

> 用户原话：目前有一些concept图片（附图）。不过这需要完成基础功能测试，到结构设计时再最后确认。

状态：参考图已提供；尺寸与结构待验证。

关联：A-REQ-043。

### 27. A5-Q03

问题：重量希望接近哪台相机，或能接受多重？没有概念可以写“待称重和握持比较”。

> 用户原话：待称重和握持比较

状态：已回答：待实测。

关联：A-REQ-044。

### 28. A5-Q04

问题：一次出门，希望持续使用多久才需要充电？可以用“几小时、半天、一天”描述，实际续航待测。

> 用户原话：目前考虑电池大小是5v3a的2500毫安电池。内置在相机里。实际续航待测试。

状态：候选规格；容量单位及基准电压待核实；续航待测。

关联：A-REQ-042、A-REQ-045。

### 29. A5-Q05

问题：实体快门希望采用普通按键，还是保留此前参考中的拉杆形态？

> 用户原话：我希望是拉杆形态。如果设计成熟，我希望把录制视频和拍照分开。拉杆形态是拍照，按键是录制视频。不过暂时先不考虑视频录制。

状态：拉杆已确认；视频控制后续。

关联：A-REQ-003、A-REQ-005、A-REQ-006、A-REQ-046、A-REQ-054。

### 30. A5-Q06

问题：取 microSD 时，是否要求不拆机壳、只打开卡槽盖就能取出？

> 用户原话：是的。希望不要拆机壳取卡，只打开卡槽盖就能取出 microSD

状态：已确认。

关联：A-REQ-040。

### 31. A5-Q07

问题：新增零件和机壳是否有预算上限或希望完成的时间？暂时没有限制可以留空。

> 用户原话：零件没有上线。不过大部分打算使用拓竹的3D打印机（X2D）来完成大部分零件，元器件则可以网上或者华强北购买。

状态：按上下文记录为未设零件预算上限；型号原样保留待核实；时间未指定。

关联：A-REQ-047。

### 32. A6-Q01

问题：是否把其余已确认功能都作为首台必做？直方图、曝光锁定、自拍延时已按你的“必须”记为P0；如有可以延后的功能，请指出。

> 用户原话：是的

状态：已确认其余当前功能为首台P0；Q38的RAW实际拍摄延后作为明确例外。

关联：当前首台范围；A-REQ-023、053至057、059。

### 33. A7-Q01

问题：从按开机键到可以拍照，最多愿意等多久？没有概念可以先测现状。

> 用户原话：待测试。当然越快越好。

状态：已回答：目标待实测。

关联：A-REQ-048。

### 34. A7-Q02

问题：按快门到真正拍到画面，能接受多少延迟？可以先描述“要能抓瞬间”或“可以短暂等待”，再用实测定值。

> 用户原话：要能抓瞬间

状态：体验目标已确认；时间待实测。

关联：A-REQ-049。

### 35. A7-Q03

问题：拍完一张后，多久能拍下一张才可接受？可以给大致时间，也可以先测。

> 用户原话：没有概念，是不是要取决于读卡速度？这个可以通过测试后再研究。

状态：已回答：待实测；分解编码与写卡等环节。

关联：A-REQ-050。

### 36. A7-Q04

问题：是否同意以下建议：没真正保存成功就不提示成功；卡满、保存失败或相机未就绪时，清楚提示原因和可做的操作？

> 用户原话：可以通过声音来提示。保存成功和保存失败分别有对应的音效。并且画面也需要提示对应的异常状态。

状态：已确认。

关联：A-REQ-051。

### 37. A8-Q01

问题：是否同意用“按约定场景带出门完整拍一轮，加上开机、拍照、保存、导出、关机逐项检查”验收第一台？还有什么必须通过的使用场景，可以补充。

> 用户原话：应该先检查开机、拍照、保存、导出和关机，这些基本功能，然后才外出拍照测试。

状态：已确认验收顺序。

关联：A-REQ-052。

## v0.1.3补问与回答

### 38. A2-Q07

问题：选2×时，RAW必须只保存裁切区域像素，还是接受保留全幅原始数据、通过裁切信息让软件默认显示2×？

> 用户原话：我希望是后一种。但是我觉得这有点难度。我的决定是，UI界面保留raw的选择，但是现阶段不执行raw的拍摄功能，还是以jpg为主。只是提供这个选择，但是用户选择后，会显示raw暂不支持。

状态：首台仅实际拍JPEG；保留RAW相关提示入口。后续偏好全幅RAW加裁切信息，兼容性待后续验证。

关联：A-REQ-009、023、056、057。

### 39. A2-Q08

问题：选1×加1:1、16:9等比例时，是否允许按比例裁切？建议1×表示没有额外2×放大，比例裁切仍生效、取景与照片一致。

> 用户原话：是的

状态：已确认1×仍允许所选比例裁切。

关联：A-REQ-009、021、024。

### 40. A3-Q08

问题：没有上次设置的首次开机，曝光、白平衡、倍率、比例和保存格式分别默认什么？后续仍恢复上次设置。

> 用户原话：曝光ev为0，白平衡为自动，倍率是1x，比例是9:16（竖屏拍摄），保存格式默认jpg

状态：本题五项默认已确认，Q45进一步明确首次自动曝光；不将本题标为漏答。

关联：A-REQ-021、025、026、058。

### 41. A3-Q09

问题：自拍延时需要哪些秒数选项？

> 用户原话：分别是3s，5s，10s

状态：已确认三个选项：3s、5s、10s。默认和取消等细节未决定。

关联：A-REQ-031。

### 42. A4-Q07

问题：JPEG+RAW是否在相册算一张照片、删除时同时删两个文件？删除是否再次确认？

> 用户原话：是的，预览时只展示jpeg，删除时两个文件同时删除。删除时仅提示「是否确认删除」即可，无需提示raw删除这件事。

状态：当前JPEG删除先确认“是否确认删除”；双格式逻辑照片、JPEG预览与配对删除规则留给后续RAW。

关联：A-REQ-037、059、060。

### 43. A4-Q08

问题：等待保存后关机时出现保存失败，是否取消这次关机、保留错误提示，待处理后再关机？

> 用户原话：如果出现保存失败，则停止关机，并提示用户报错。

状态：已确认取消本次关机，保持开机并报错。

关联：A-REQ-039、051。

### 44. A4-Q09

问题：拍后回显除了默认3s，还需要关闭回显、其他秒数或手动返回中的哪些选项？

> 用户原话：需要关闭回显，秒数可以设置3s和10s两个选择。

状态：已确认关闭、3s、10s三个选项；默认继续为3s。

关联：A-REQ-034。

## v0.1.4补问与新增要求

### 45. A3-Q10

问题：首次曝光模式是否采用自动曝光、曝光补偿EV 0？后续继续恢复上次模式。

> 用户原话：是的。自动曝光

状态：已确认首次自动曝光；EV 0沿用Q40，后续继续恢复上次曝光模式。此题关闭。

关联：A-REQ-025、058；A-DEC-055。

### 用户主动新增：触屏拍照

> 用户原话：我刚想到，拍照功能在触摸屏里也需要有。可以在触摸屏上直接点击拍照。

状态：已确认首台P0；触屏直接点击拍照，实体拉杆继续保留。两入口共用既有拍摄规则，按钮布局留给C细化，不从概念图擅自指定尺寸。

关联：A-REQ-006、038、061；A-DEC-056。

## 当前待回答清单

本轮已发出的1至45题均已回答，无待答项。下列详细规则尚未完成确认，之后集中在本对话按顺序提问。

## 后续待细化清单

不是本轮漏答，也不填未经确认的默认值。之后在本对话集中按顺序提问；待测项先取得真实证据。

- A2：JPEG输出尺寸与可接受清晰度，先看样片；真实RAW与兼容性为后续。
- A3：直方图类型/显示，曝光锁定范围/触发/解除；自拍默认开关、取消与倒计时；控制单位、范围与自动限制阈值。
- A4：回显计时起点/提前结束，图库详细操作，记忆失效恢复；其他设置是否记忆尚未追加确认。
- A5/A7：体积、重量、续航、温度及启动/触发/再拍速度，按实测后再定数值。
- A8：测试次数、条件、阈值与容差，待功能和样片证据齐备后形成基线。

## 表述解释与未确认建议

- Q23原文“正在保持照片”按上下文解释为正在保存照片，没有新增其他动作。
- Q24“两则”按上下文记录为Mac、Windows两者。
- Q31“零件没有上线”按上下文记录为未设零件预算上限；拓竹X2D按用户原话保留，不声明型号已核实，未获得完成时间。
- Q28的2500“毫安”保留原话，未自动改成已经核实的mAh规格、未推算续航。
- Q39明确1×是不加2×放大，比例裁切仍生效；Q38明确RAW全幅加裁切信息为后续偏好。
- 38至44规则均已回答；实际RAW与双格式当前不执行，配对删除规则留后续。删除提示按原话“是否确认删除”。
- “JPEG”“JPG”在本稿指同一当前格式，不据此限定扩展名。
- RAW和JPEG+RAW两个入口都涉及RAW；当前均作暂不支持提示入口。保持JPEG为有效状态且清楚显示是A的交互建议，未列为用户原话。
- EV 0与曝光模式分别记录；Q40给EV 0，Q45已明确首次自动曝光，当前没有首次模式待答项。
- 新增触屏拍照是同一拍摄功能的第二入口；实体拉杆保留，既有单张、自拍、忙碌、保存反馈和回显规则共用。具体布局由C设计。
