Junshu111/junshu-camera/AI-WORKFLOW.md

# AI 新手引导流程

本文件用于观众明确提出“跟着教程开始做自己的相机”时的引导。普通代码维护、排错、审阅或只读资料请求不自动触发建项目、建对话或搭环境。当前用户指令和本机更高优先级规则始终优先。

目标是先让新手有一个找得到资料、知道下一步的工作台，再逐步做自己的相机。提示词能传递任务，实际执行仍依赖所用应用的工具、访问权限、网络与用户操作。

## 1. 先读资料，第一条回复只做入口选择

读取 README.md、AGENTS.md、GETTING-STARTED.md、本文件、RELEASE-CONTENTS.md 和 workflow/roles.json。只拿到网址时，应实际获取这些文件；不能把看到仓库名字当成读完资料，也不能假设网上的 AGENTS.md 已自动成为当前工作目录的规则。

能读取时，用简单中文回复：这是自己的相机项目，目前可建立工作台、阅读教程，并参考已公开的软件源码与模型；这些参考对应原硬件，读者自己的适配与实测仍需逐步完成。然后展示下面的文字分工图，说明它是计划、不是已创建的结果：

```text
我的自制相机
├─ 相机 00｜总工作台：路线、进度、下一步
├─ 相机 A｜目标与路线
├─ 相机 B｜零件与购买
├─ 相机 C｜系统与软件
├─ 相机 D｜接线与供电
├─ 相机 E｜外观与三维打印
└─ 相机 F｜组装与验收
```

第一条回复只问一个选择：

- A：新建独立项目，并准备这七个对话（推荐）。
- B：在当前项目准备这七个对话。

说明：项目像资料文件夹、对话像分工工作台；选择后再引导。此时不要主动下载到本机、写文件、创建对话或安装软件（只读获取远程文档可以）。已有明确选择则沿用，不重复询问。用户明确要求单对话时也接受，不强制七个对话。

如果无法获取仓库，先坦诚说明未读到哪些资料，并给一个可执行的下一步，例如让用户下载 ZIP、在应用中打开文件夹或粘贴指定文档；不要猜出后续内容或要求账号写入权限。已有本地副本时优先读取，不重复下载。

## 2. 选择项目后，确认资料放在哪里

先识别当前工具：桌面应用、CLI、IDE 或普通聊天；本机或云端；能否读文件、运行命令、管理侧栏项目和对话。分别说明实际能力，不能假定观众拥有作者的插件、账号、模型或本地路径。只读仓库不需要 GitHub 写入授权。

### A：新建独立项目

1. 建议名称“我的自制相机”，由用户决定保存位置。已有同名目录先检查、复用或另选名字，不覆盖。
2. 有可靠的项目创建能力时，在用户选择的范围内使用；没有时，一次只引导用户在侧栏或项目视图中新建／添加本地项目，再关联资料文件夹。界面按钮随版本变化，先核对当前界面；看不到界面时说明大致操作目标，让用户描述实际选项，不编造按钮位置。
3. 资料可通过已有副本、已有 Git 工具克隆，或 GitHub Code → Download ZIP 解压获得。不要为下载公开资料先安装 Git、Node.js 或申请仓库写权限。
4. 在新项目打开相机资料目录。原聊天能移入时按用户选择移入；不能移入时，给新项目的“相机 00”一份连续交接，注明资料位置、项目选择和当前阶段。

### B：使用当前项目

1. 确认当前项目确实存在，并核对它实际可访问的文件夹。尚在项目外时，带用户选择已有项目。
2. 相机资料放在当前项目内独立的 diy-camera 子目录，或复用已存在的正确资料目录。不要改写其他项目根目录的 AGENTS.md、依赖、Git 配置或既有文件。
3. 若相机目录不是项目主目录，要在每个对话启动文字中明确资料位置，并显式读取相机资料目录的 AGENTS.md；不要假设应用会自动发现次级目录中的规则。

### 只有 CLI、IDE 或普通聊天

CLI 用相机资料目录作为工作目录（已有 Codex CLI 时可从该目录启动）；IDE 打开相机资料文件夹；它们不等同于桌面侧栏项目。没有对话管理工具时指导用户手动新建聊天。没有本机文件访问时，采用“网页／粘贴阅读模式”：资料来源记录为实际读到的仓库网页或用户粘贴内容，本机目录可记“用户未提供／当前 AI 无访问权限”。只要必读资料确实读到，就可以建立阅读分工并继续教程；不能宣称本地环境已搭好或已运行命令。用户可以选“先用一个对话”，之后再拆分。

资料可访问后，在资料目录的 .camera-work/ 中保存观众自己的记录：从 workflow/templates/STATUS.md 和 THREADS.md 复制初始模板；已存在则读取并增补，不覆盖。没有写入能力时提供可复制文本，标注尚未保存；由用户把最新摘要转贴给其他对话，不把未保存文本说成共享文件。

## 3. 创建或复用七个用户可见对话

角色的准确名称、职责与章节在 workflow/roles.json；每个角色的启动交接在 workflow/handoffs/00.md、A.md 至 F.md。

用户选择 A 或 B 时，已经选择建立七个对话。先查目标项目中是否已有正确角色的对话，优先复用。只在所选项目中创建缺少的对话；不指定模型、不创建额外 worktree、不批量启动开发。后台子代理不等于用户侧栏中的独立对话。

“相机 00”优先复用当前引导对话（前提是它确实属于目标项目且能访问资料）；无法复用时才创建，避免多一个重复总工作台。其余六个分别使用对应 handoff。当前引导对话复用为 00 时，完成自身就绪核对后继续筹备 A—F，不因“待命”停止；如果另建 00，原引导先完成筹备核对，再把最新摘要和“请接管下一步”交给新 00，明确谁负责继续，避免两个总工作台互相等候。

### 有创建对话的工具

- 使用应用提供的真实项目／对话工具。先列出项目，核对目标，再创建或复用。
- 每个对话的首条消息应包含：自己的角色、仓库 URL、本次观众的资料来源（本地模式填真实绝对路径；网页／粘贴模式填实际 URL 或粘贴文档清单）、所选项目与当前阶段，以及对应 handoff 的完整内容。
- 只允许读取交接并回复就绪，不得开始开发、安装、购买、接线或打印。
- 创建可能异步完成。记录返回的真实 ID／链接，等待或读取对应对话的实际回复，确认交接读取；不无限重试、不把“已排队”写成“已就绪”。

### 没有创建对话的工具

先核对并复用当前 00 和已存在的正确角色，再按 A—F 顺序只创建缺少项；每次只带用户操作一个对话。用户转贴的真实就绪回复也可作为核对证据。告诉用户要用的标题，并给一段可直接发送的启动消息：仓库 URL＋本次已确认的资料来源／阅读模式＋对应 handoff 全文。不要只说“按模板操作”，也不要让新手自己猜占位符。

用户创建后，让该对话按 handoff 回复；用户可把回复转贴给 00。无法直接读取其他对话时，记录为“用户转贴核对”或“待用户确认”，不伪造已查看。本地模式的项目或目录尚未确定时，先完成第 2 步再给带路径的启动消息；网页／粘贴模式不要求本地路径，也不冒充本机已搭建。

## 4. 核对交接，而不是只数聊天数量

按 workflow/templates/THREADS.md 的七行核对：对话是否在所选项目、能否访问同一套资料（本地目录或网页／粘贴文档）、是否读了对应 handoff、职责是否正确。返回成功只能证明创建；实际回复才能证明读完交接。

就绪回复应包含“实际读取的文件、资料位置、一句话职责、缺失信息和当前待命状态”。记录就绪级别：“本地资料就绪”或“资料阅读就绪（网页／粘贴）”。后者可以继续读教程，但本机文件、共享状态和环境自检仍待用户操作。没有硬件信息不妨碍工作台就绪；无法读取基本资料则交接未完成。遇到某个对话卡住，列出那个对话的具体原因，不抹掉其余进度。

共享文件不等于共享聊天记录。本地模式由 00 维护 STATUS.md 和 THREADS.md，A—F 各写自己的 A.md 至 F.md；网页／粘贴模式由 00 提供最新状态摘要，用户转贴，明确未保存到本机。跨角色传递“事实、证据、未完成项、下一步”，避免同时修改同一个文件。只有用户的具体后续任务才触发某个角色工作。

## 5. 从最小的电脑端步骤开始

七个对话就绪后回到 00；用户选单对话后备时直接在当前对话继续，并记明“未建立七对话”。不要让不会创建聊天成为阅读教程的障碍。

按顺序逐个完成，每次只给一个操作和完成标志：

1. 核对电脑系统和资料目录。可用工具只读识别，否则问用户，不能把云端 Linux 当作观众的 Mac／Windows。
2. 确认 docs/index.html 能打开。纯阅读无需安装依赖。
3. 若当前运行位置已有 Python 3，在资料根目录运行 `python3 tools/check_site.py`；Windows 按现有命令可用 `py -3 tools/check_site.py`。记录真实输出。无 Python 时先手动阅读与核对链接，标为“未运行自检”；需要编辑教程时再讨论是否安装，不自动装一套开发工具。
4. 再运行 `python3 tools/check_onboarding.py` 检查引导资料，以及 `python3 -B tools/check_reference.py` 检查软件与模型参考完整性；同样遵守 Python 已有才运行。
5. 回到第 01 章，从“希望拍什么、目前有哪些零件”开始。预算和设备未知时每次问一个问题，不先推荐一篮子购买或执行硬件脚本。

这次启动不连接／写入树莓派，不重写存储卡、不改启动、不接线、不购买、不打印、不发布用户文件。之后用户提出具体硬件任务时，重新核对型号、系统、供电、材料、当前文档和任务边界。

不能把这份教程的 20 页静态自检写成相机软件测试、硬件连接成功或整机验收通过。软件源码与模型位于 software/ 和 models/，先读取各自 README、版本选择与 RELEASE-CONTENTS.md。必须说明参考版的适用条件、未完成实测和下一步；不把原设备限定安装入口当通用安装器，不编造一键适配承诺。

## 6. 每次收尾都能接着做

用中文简洁列出：所选项目、资料位置、对话核对表、电脑端检查结果、尚缺资料、下一步的一个动作。新手只需跟着 00，不必一次操作七个对话。

如果用户暂时离开，写一份简短交接；下次先读自己的状态记录，继续未完成步骤，不重复下载、重复建七个对话或重装环境。

## 能力依据与适用范围

2026-10-31 核对的官方资料：[项目与对话](https://learn.chatgpt.com/docs/projects)、[AGENTS.md 的发现规则](https://learn.chatgpt.com/docs/agent-configuration/agents-md)。它们说明目录、项目上下文和独立聊天的关系；没有保证所有应用都能由一句提示词自动创建项目和七个对话。本流程以当前可用工具为准，并提供手动后备。
