Junshu111/junshu-camera/START-HERE.md

# 第一次来，从这里开始

你可以先让 AI 帮你建立相机工作台，再一步步学习。第一次只准备项目、分工和电脑端阅读环境，不需要先买齐零件。

1. 在 Codex 等 AI 工具中新开一个对话，发送这个仓库链接：
   https://github.com/Junshu111/junshu-camera
2. 打开[网页上的两步入口](https://junshu111.github.io/junshu-camera/setup.html)，点击“复制这段话”，发到同一个 AI 对话里。
3. AI 会先解释分工，并让你选“新项目＋七个对话”或“当前项目＋七个对话”。推荐用单独的新项目，方便以后找资料。你也可以继续用当前项目。
4. 按 AI 的说明完成项目和对话准备，再核对资料能否读取、电脑端自检和第一章。

项目像一个装资料的文件夹；对话像分工不同的工作台。电脑上的文件夹、应用侧栏里的项目和聊天记录是三件不同的事，AI 应帮你把它们对应起来。

## 你接下来会看到什么

```text
我的自制相机（新项目或当前项目）
├─ 相机 00｜总工作台：告诉我下一步，记录进度
├─ 相机 A｜目标与路线：想做什么，预算多少
├─ 相机 B｜零件与购买：认零件，核对购买清单
├─ 相机 C｜系统与软件：电脑环境、系统与拍摄软件
├─ 相机 D｜接线与供电：端子、连接与供电
├─ 相机 E｜外观与三维打印：尺寸、外壳与打印
└─ 相机 F｜组装与验收：安装与最终检查
```

七个对话准备好以后，先在“相机 00｜总工作台”继续。其他对话只读交接、待命，不会同时开始安装或制作。它们不自动共享所有聊天，靠共同记录和简短交接保持一致。只用网页聊天、无法读取电脑文件时，可以按“网页／粘贴阅读模式”先开始，进度由你转贴；这时 AI 不能核实本机环境。

## AI 不能自动创建时

不同应用、版本和权限的功能不同。AI 有创建对话的工具时可以帮你创建；没有时，它会一次带你新建一个对话，并给你对应的启动文字。新建项目也可能需要你在应用里操作。你不必安装额外插件或开放所有文件权限才能开始阅读。

只有一个对话也能先开始：告诉 AI“先用当前对话带我做”，后续再拆分。CLI、IDE 和普通网页聊天的界面可能不同，按当前应用实际支持的方式操作。

## 网址读不了、仓库下载不了

先让 AI 说明具体卡在哪里。可以在 GitHub 仓库页面选择 Code → Download ZIP，解压后在 Codex 中打开该文件夹；如果连 ZIP 都下载不了，就先在[教程网站](https://junshu111.github.io/junshu-camera/)阅读。公开阅读和下载不需要给 AI 你的 GitHub 写入权限。

如果使用只能聊天、不能读取电脑文件的 AI，可以把 README、GETTING-STARTED 和 AI-WORKFLOW 的内容粘贴给它，由它逐步指导你操作。不要把它说出的“已完成”当作电脑已经发生了变化。

## 目前提供到哪里

这一版提供中文教程、AI 协作流程、七角色启动交接和核对模板。另有[相机软件和模型参考资料](RELEASE-CONTENTS.md)，包含本次使用的源码和可编辑／打印文件；适配其他零件和设备仍需逐项核对，无法仅凭网址自动装好相机。可以先建立自己的工作台、了解零件和准备环境，后续按匹配硬件逐项验证。

完整的 AI 执行顺序见 [AI-WORKFLOW.md](AI-WORKFLOW.md)，电脑端操作见 [GETTING-STARTED.md](GETTING-STARTED.md)。PDF 暂不发布，频道视频制作资料不在公开范围内。
