Junshu111/junshu-camera/workflow/templates/STATUS.md

# 我的相机进度

这是待填写的模板，不是 原样机或本机实测结果。首次复制时保留“待确认”；已有状态文件只增补，不覆盖。

- 项目方式：待选择（新项目／当前项目／单对话后备）
- 应用与运行位置：待确认（桌面／CLI／IDE／普通网页聊天；本机／云端）
- AI 实际运行系统与位置：待确认
- 用户电脑系统：待确认（不能从云端系统推断）
- 资料模式：待确认（本地目录／网页或用户粘贴阅读）
- AI 可访问的资料副本目录或网页／粘贴来源：待确认
- 用户电脑资料目录：待确认（未被 AI 实际核实则注明）
- 工作记录目录：资料目录下 .camera-work/
- 相机目标与预算：待确认
- 主板、镜头、屏幕、供电、控件：待确认
- 打印机与本次材料：待确认
- 当前阶段：工作台准备
- 教程自检：未运行
- 硬件实测：未进行
- 已确认的决定：无
- 当前问题：无
- 下一步：完成项目选择、资料访问和对话交接，再做电脑端只读核对

## 工作记录

按日期追加事实、证据、未完成项和下一步。不要保存密码、令牌、Wi-Fi 密码或他人的隐私资料。
