Junshu111/junshu-camera/workflow/templates/THREADS.md

# 对话就绪核对

这是空白记录，不能将模板当作已创建或已就绪证据。

| 角色 | 对话名 | 所属项目与资料来源 | 实际对话链接或 ID | 创建／复用状态 | 交接读取状态 | 核对证据 |
| --- | --- | --- | --- | --- | --- | --- |
| 00 | 相机 00｜总工作台 | 待确认 | 待确认 | 待创建 | 未核对 | 无 |
| A | 相机 A｜目标与路线 | 待确认 | 待确认 | 待创建 | 未核对 | 无 |
| B | 相机 B｜零件与购买 | 待确认 | 待确认 | 待创建 | 未核对 | 无 |
| C | 相机 C｜系统与软件 | 待确认 | 待确认 | 待创建 | 未核对 | 无 |
| D | 相机 D｜接线与供电 | 待确认 | 待确认 | 待创建 | 未核对 | 无 |
| E | 相机 E｜外观与三维打印 | 待确认 | 待确认 | 待创建 | 未核对 | 无 |
| F | 相机 F｜组装与验收 | 待确认 | 待确认 | 待创建 | 未核对 | 无 |

创建工具返回成功，只能记为“已创建”；收到对应对话的真实就绪回复，才能记为“已读取”。手动创建时可根据用户转贴的回复记为“用户转贴核对”。无法查看时保留“待用户确认”。

就绪级别分别标注“本地资料就绪”或“资料阅读就绪（网页／粘贴）”。后者不代表本机环境已搭建；没有文件写入能力时，这张表仅为用户可转贴的文本，标为未保存。
