Junshu111/junshu-camera/docs/assets/camera-detail.png

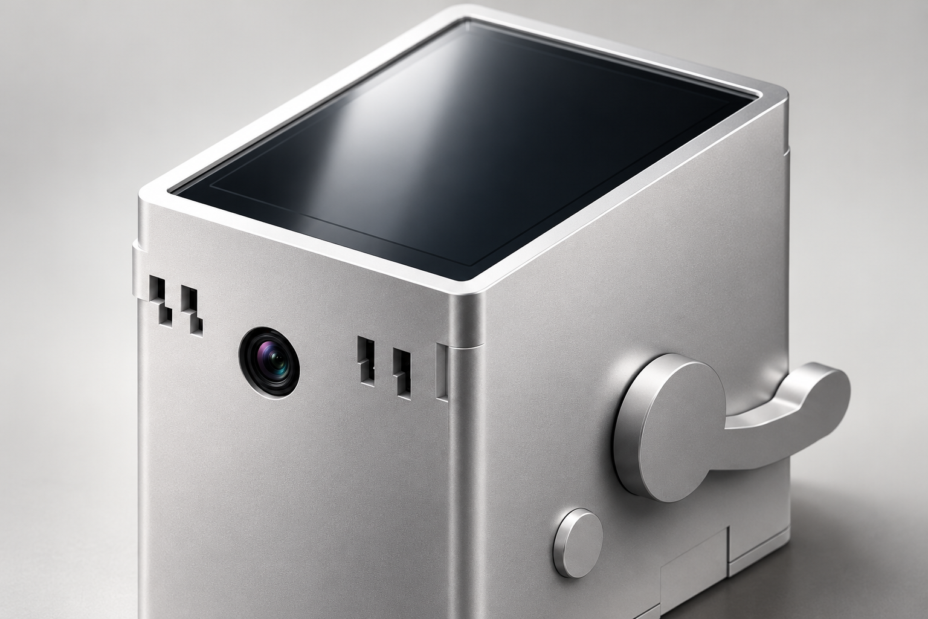
docs/assets/camera-detail.png
