Junshu111/junshu-camera/docs/assets/camera-family-lineart.png

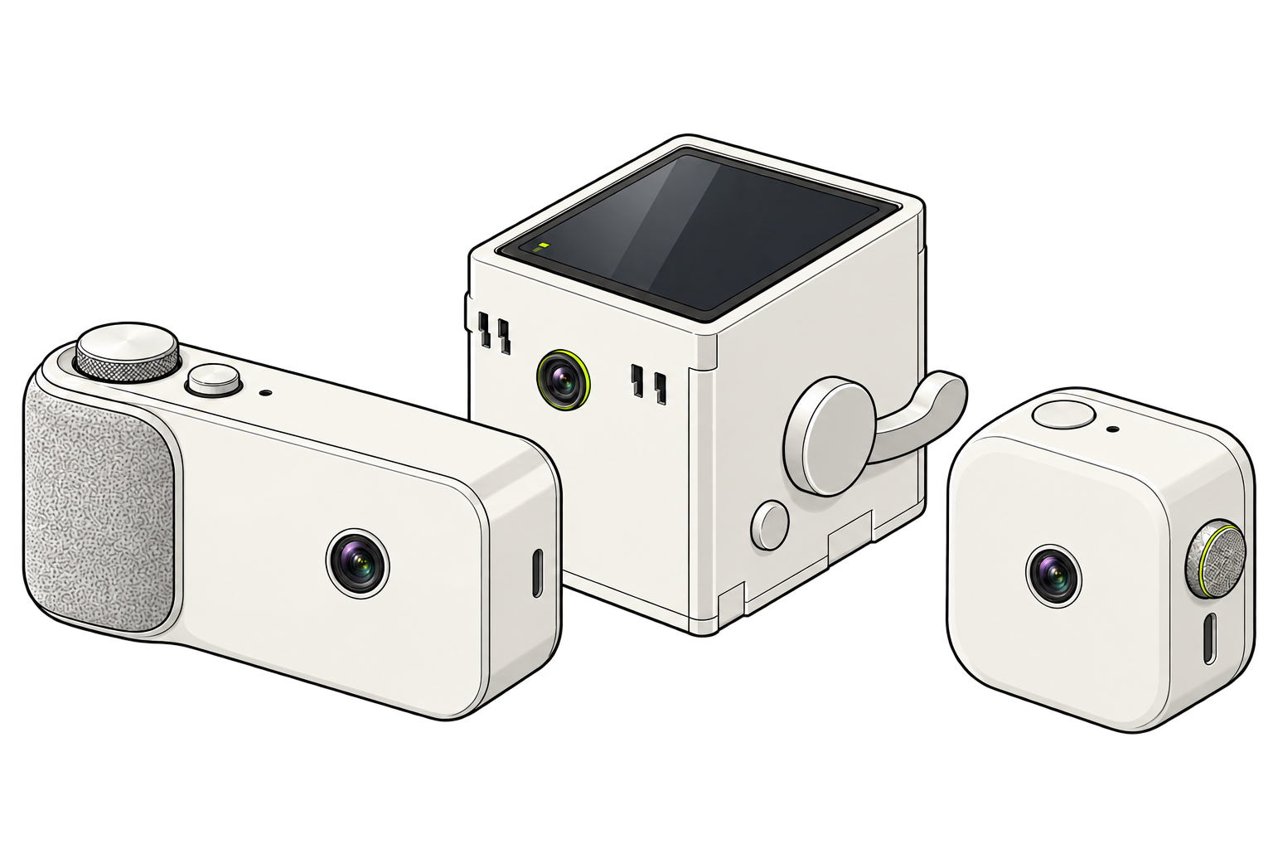
docs/assets/camera-family-lineart.png
