Junshu111/junshu-camera/docs/assets/camera-family.png

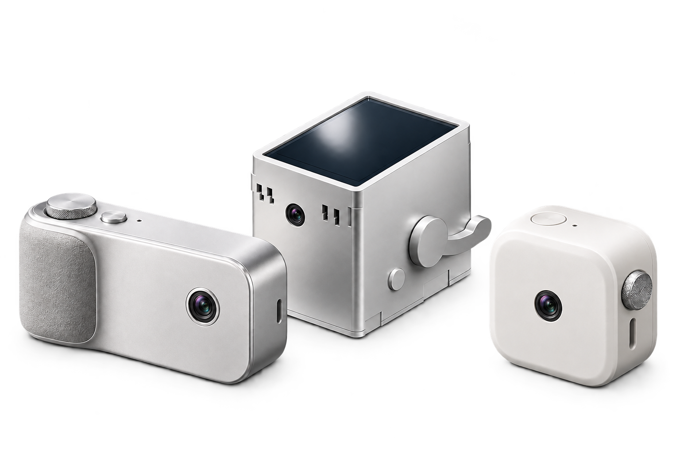
docs/assets/camera-family.png
