Junshu111/junshu-camera/models/core-20261028/illustrations/V29-镜头替换与固定位置.png

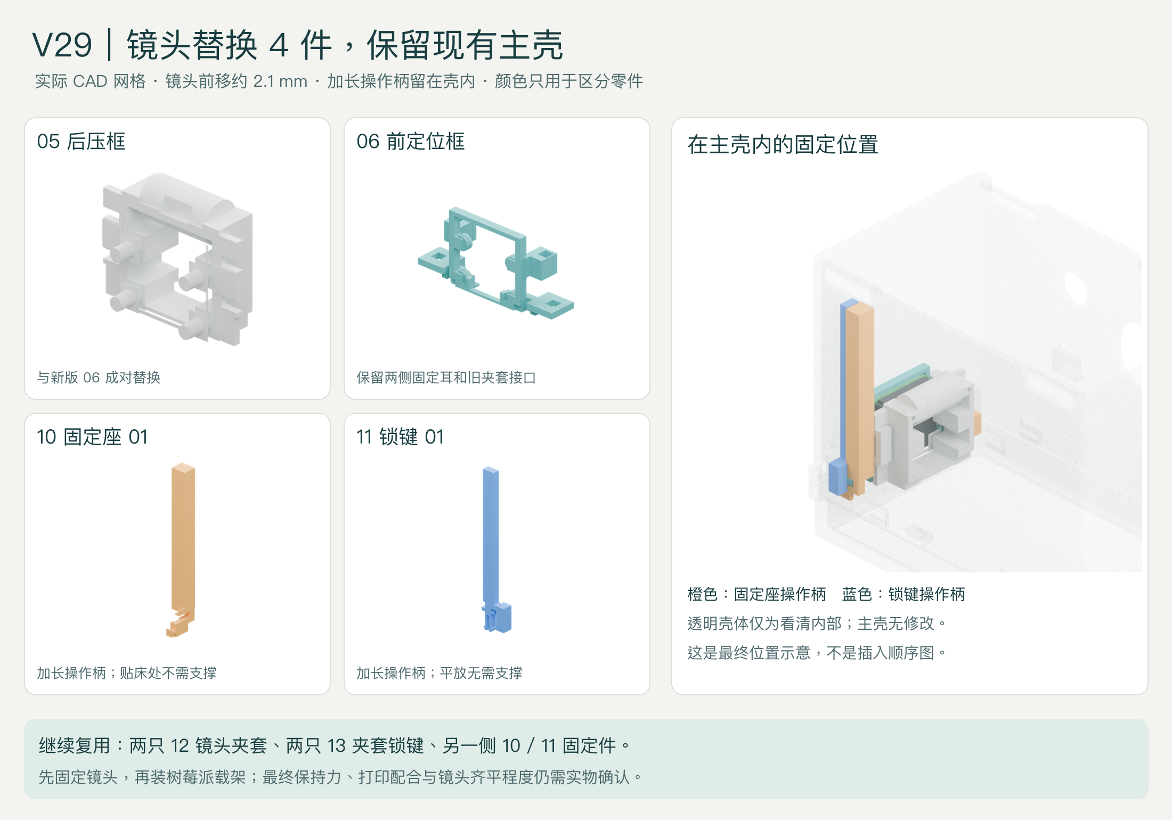
models/core-20261028/illustrations/V29-镜头替换与固定位置.png
