Junshu111/junshu-camera/models/core-20261028/illustrations/当前完整模型-三盘对照.png

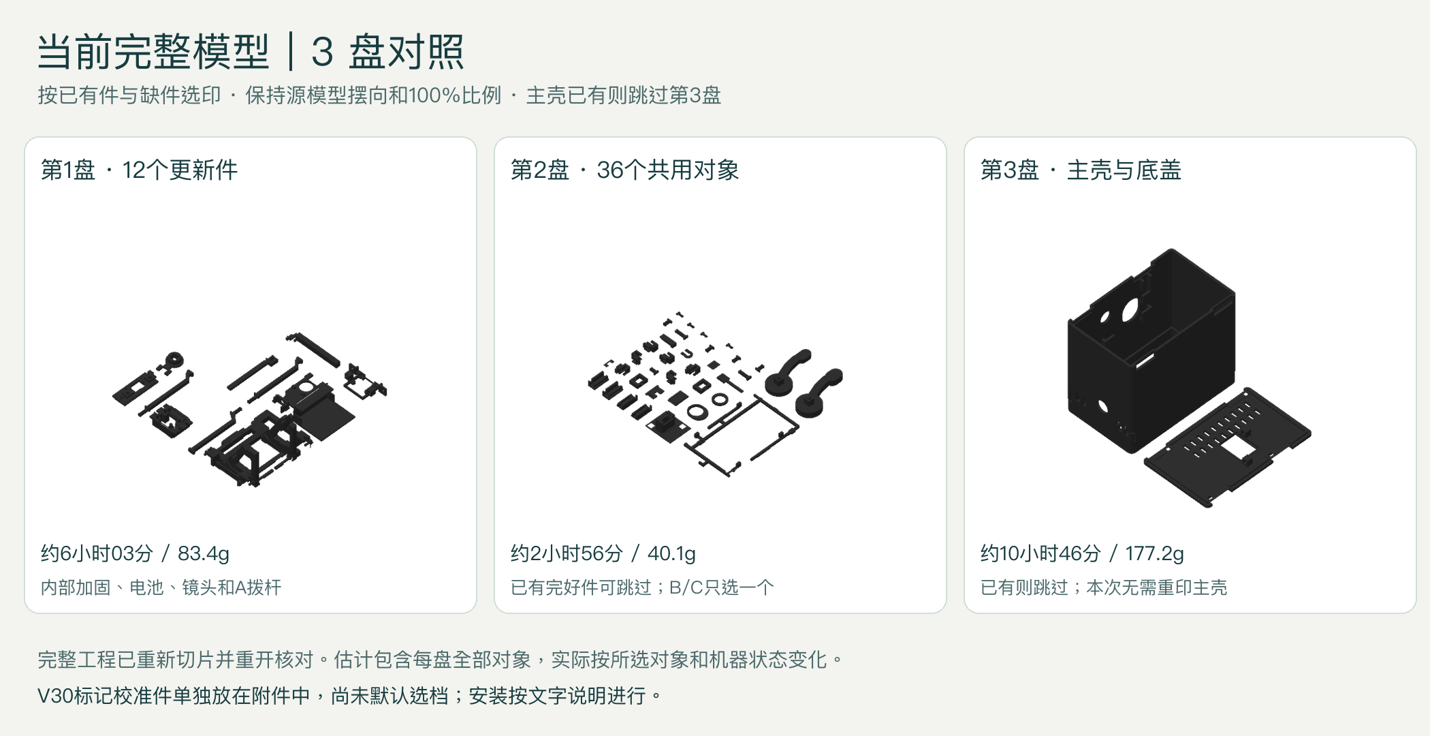
models/core-20261028/illustrations/当前完整模型-三盘对照.png
