Junshu111/junshu-camera/models/lever-v30/images/actual-top-layer-paths.png

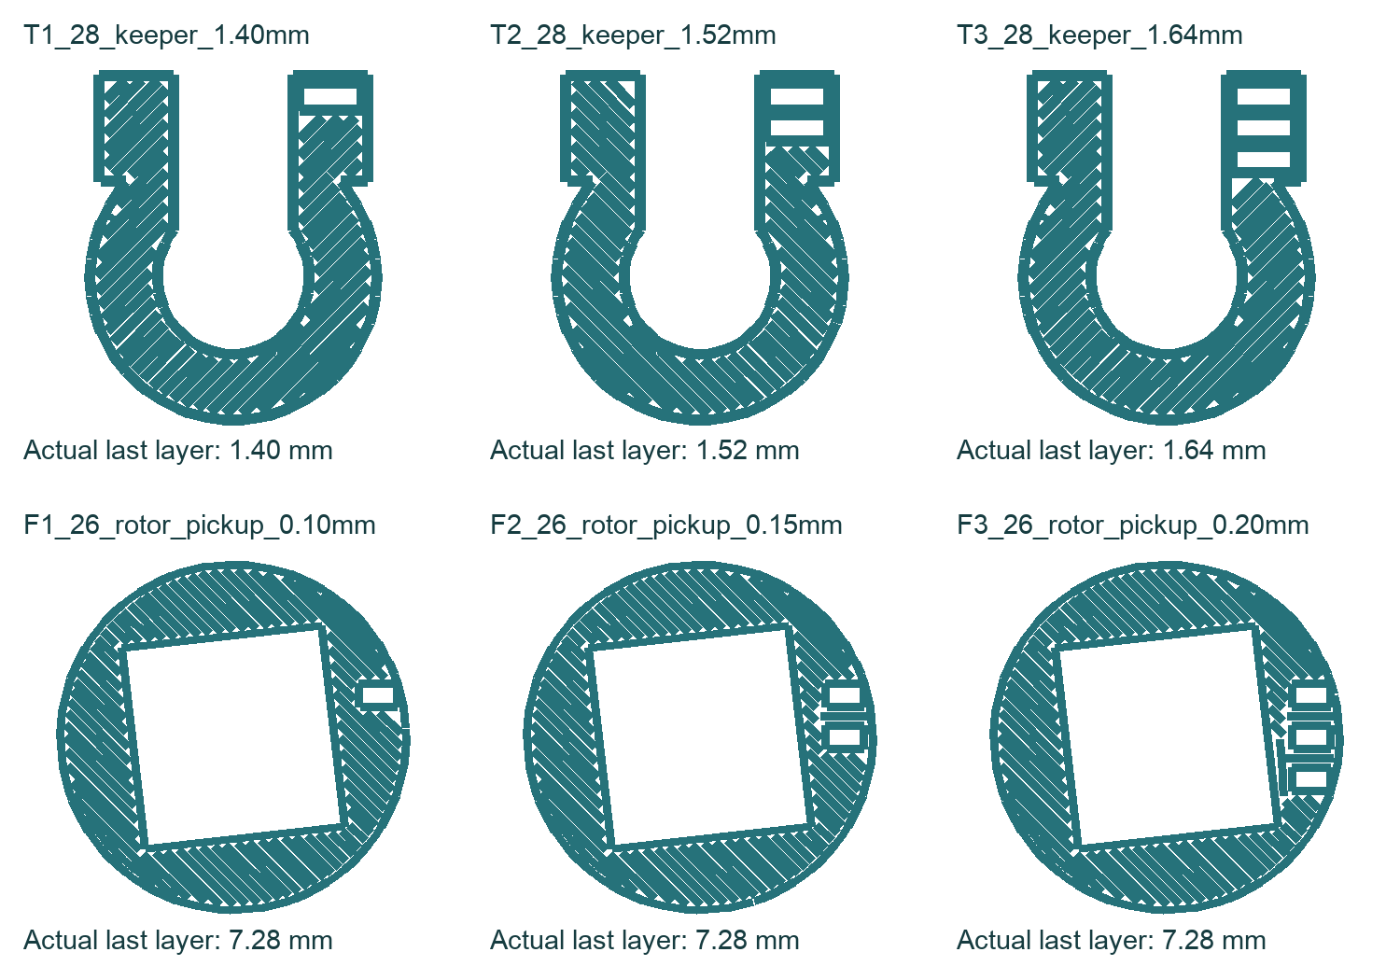
models/lever-v30/images/actual-top-layer-paths.png
