Junshu111/junshu-camera/models/lever-v30/images/V30-六件标记与测试顺序.png

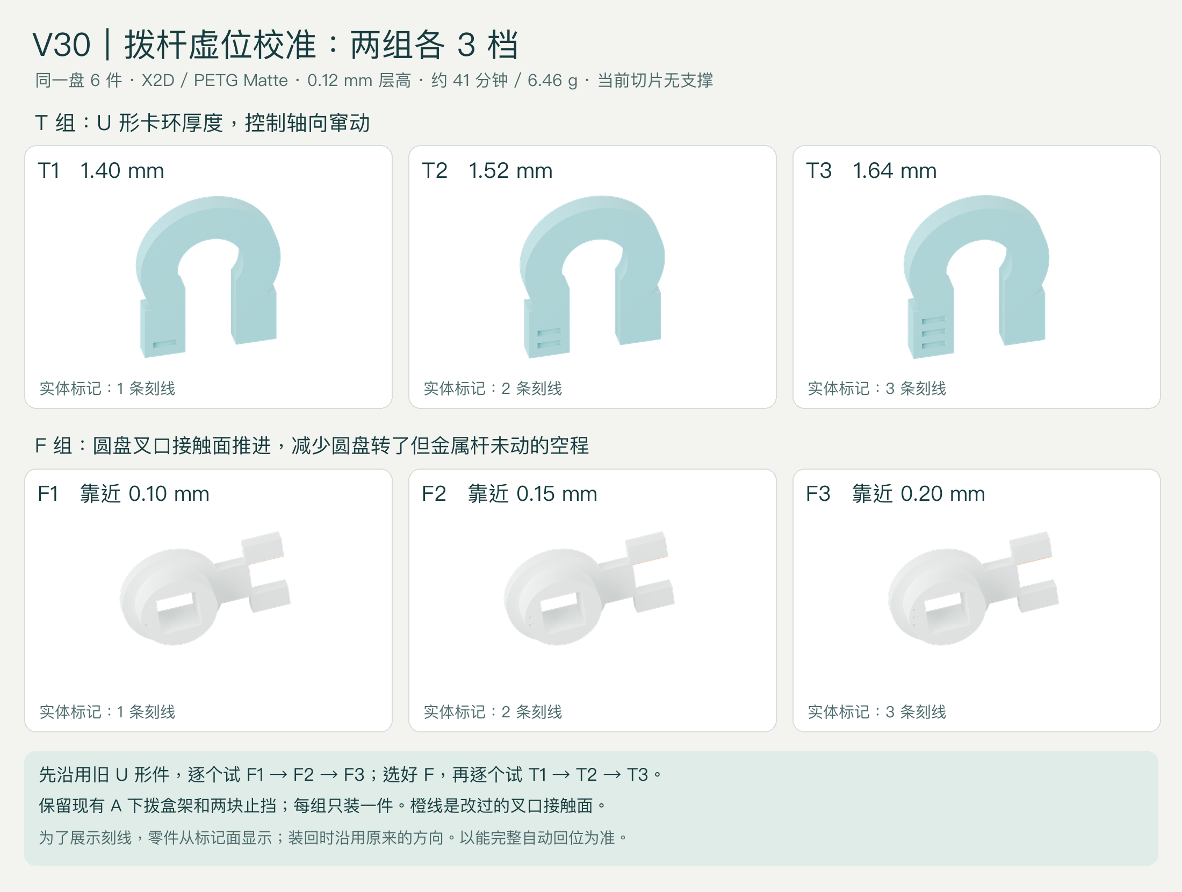
models/lever-v30/images/V30-六件标记与测试顺序.png
