Junshu111/junshu-camera/models/hood-n3-v1/guides/零件与打印清单.csv

编号 | 名称 | 数量 | STL | 打印尺寸mm | 安装朝向
01 | 卡装套框 | 1 | 01_N3_clip_on_frame.stl | 134.20 × 91.60 × 24.80 | 短边铰链对镜头端；较高长边轴线对控件侧
02 | 无控件侧长肩板 | 1 | 02_N3_noncontrol_panel.stl | 122.40 × 49.38 × 7.40 | 高肩对镜头端；铰链凸台朝屏幕
03 | 控件侧长肩板 | 1 | 03_N3_control_panel.stl | 122.40 × 49.38 × 7.40 | 高肩对镜头端；铰链凸台朝屏幕
04 | 镜头侧高板 | 1 | 04_N3_lens_high_panel.stl | 57.60 × 70.40 × 7.40 | 在镜头端；凸轮位于控件侧半边
05 | 长铰轴 | 1 | 05_N3_retaining_axle_L.stl | 5.60 × 114.00 × 3.90 | 镜头端往观看端，细尾先入
06 | 长铰轴 | 1 | 06_N3_retaining_axle_R.stl | 5.60 × 114.00 × 3.90 | 镜头端往观看端，细尾先入
07 | 短铰轴 | 1 | 07_N3_retaining_axle_F.stl | 5.60 × 67.00 × 3.90 | 无控件侧往控件侧，细尾先入
