Junshu111/junshu-camera/models/core-20261028/01_X2D_PETG_Matte_Current_Complete_20261028.3mf

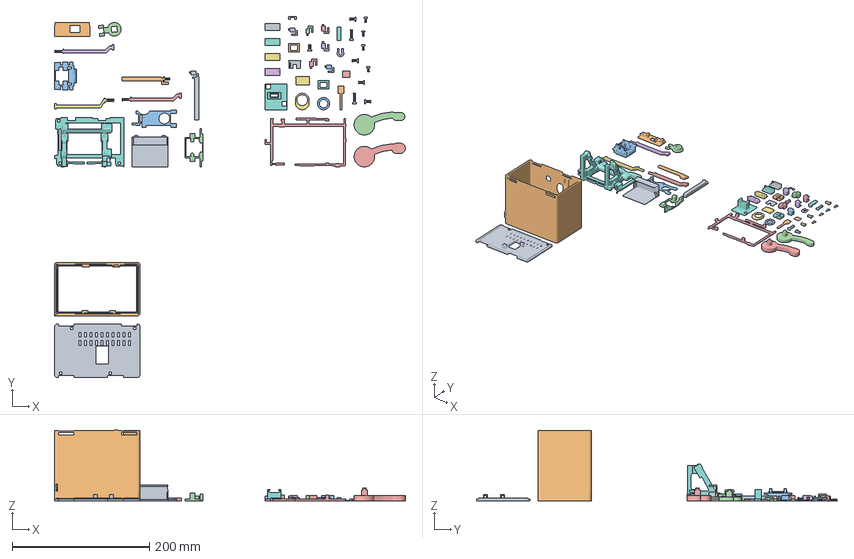
[picture p13: CAD file, 2026-10-31]
models/core-20261028/01_X2D_PETG_Matte_Current_Complete_20261028.3mf
512.0 x 526.5 x 103.2 mm
10_camera_anchor_01_access_v29.stl
11_camera_anchor_01_corner_key_v29.stl
05_camera_rear_clamp_forward_v29.stl
06_camera_front_frame_forward_v29.stl
36_long_lock_03_v28.stl
36_long_lock_04_v28.stl
36_long_lock_05_v28.stl
03_pi_carrier_access_reinforced_v28.stl
09_battery_cradle_open_end_v28.stl
07_battery_bridge_side_entry_v28.stl
A_down_25_cassette.stl
A_down_26_rotor.stl
02_screen_retainer.stl
10_anchor_shoe_02.stl
11_anchor_key_02.stl
12_camera_sleeve_22.stl
13_camera_key_22.stl
12_camera_sleeve_56.stl
13_camera_key_56.stl
10_anchor_shoe_03.stl
10_anchor_shoe_04.stl
10_anchor_shoe_05.stl
14_pi_clip_1.stl
14_pi_clip_2.stl
14_pi_clip_3.stl
14_pi_clip_4.stl
10_battery_anchor_shoe_6.stl
11_battery_anchor_key_6.stl
10_battery_anchor_shoe_7.stl
11_battery_anchor_key_7.stl
30_sliding_dust_cover.stl
31_usb-c_carrier.stl
32_rear_connector_stop.stl
33_carrier_key_left.stl
33_carrier_key_right.stl
34_axial_shim_0p68.stl
35_side_shim_0p36.stl
16_cover_clip_1.stl
16_cover_clip_2.stl
16_cover_clip_3.stl
16_cover_clip_4.stl
17_release_pick.stl
35_independent_button_washer_seat.stl
27_rearward_handle_b.stl
27_rearward_handle_c.stl
28_hidden_pivot_keeper.stl
29_concealed_bearing_liner.stl
34_rigid_cassette_withdrawal_key.stl
04_bottom_lid_recessed_usb-c.stl
01_main_body_106mm.stl
