Junshu111/junshu-camera/models/core-20261028/STL/01_main_body_106mm.stl

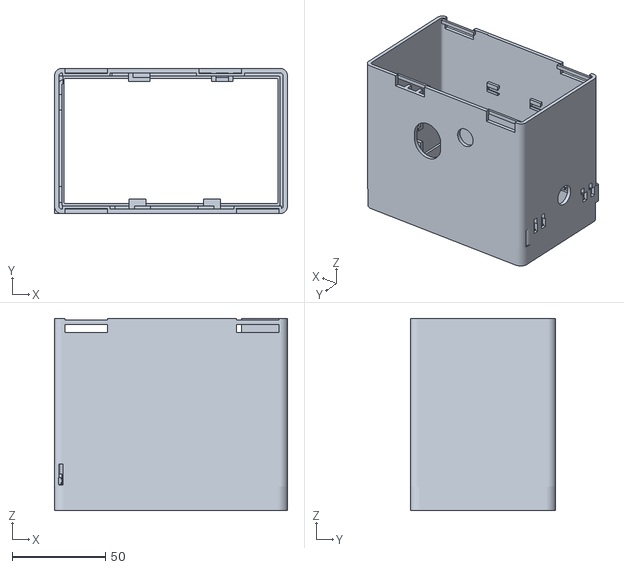
[picture p14: CAD file, 2026-10-31]
models/core-20261028/STL/01_main_body_106mm.stl
125.0 x 78.0 x 103.2
