Junshu111/junshu-camera/models/battery-v31/01_X2D_PETG_Matte_V31_Battery_48x40x20.3mf

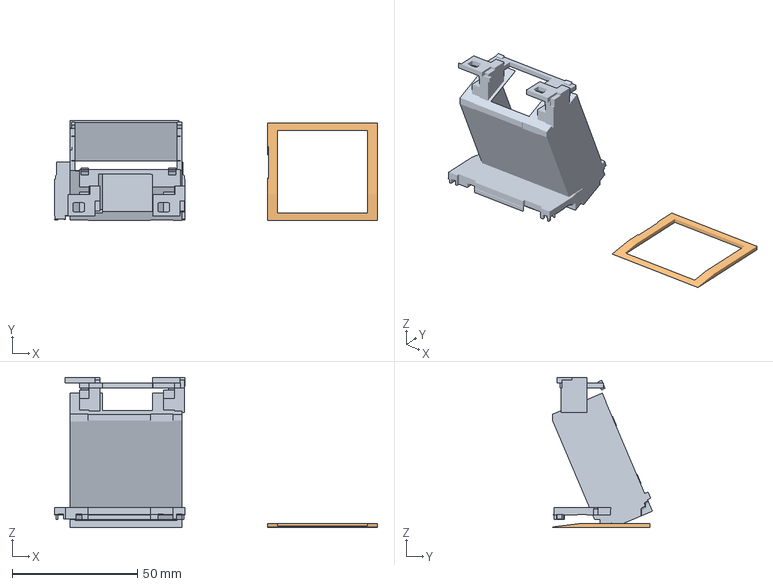
[picture p15: CAD file, 2026-10-31]
models/battery-v31/01_X2D_PETG_Matte_V31_Battery_48x40x20.3mf
129.0 x 39.9 x 60.1 mm
09_battery_wrap_v31.stl
07_battery_glue_lid_v31.stl
