Junshu111/junshu-camera/models/battery-v31/stl/07_battery_glue_lid_v31.stl

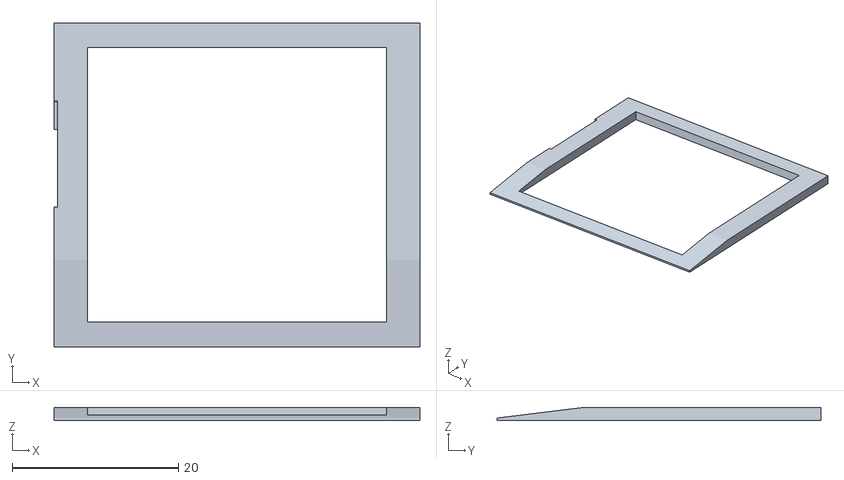
[picture p16: CAD file, 2026-10-31]
models/battery-v31/stl/07_battery_glue_lid_v31.stl
44.0 x 39.0 x 1.60
