Junshu111/junshu-camera/models/bottom-clips/01_X2D_PETG_Matte_Bottom_Lid_4_Clips_Current_20261028.3mf

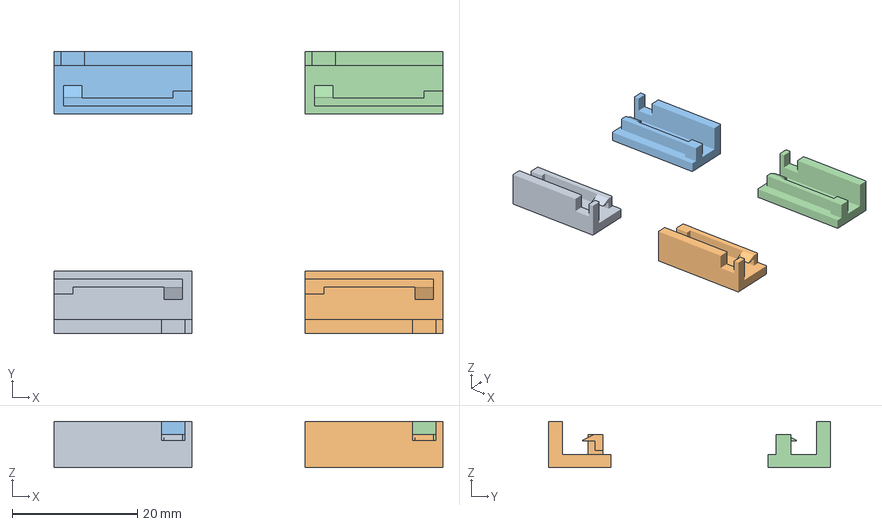
[picture p17: CAD file, 2026-10-31]
models/bottom-clips/01_X2D_PETG_Matte_Bottom_Lid_4_Clips_Current_20261028.3mf
62.0 x 44.9 x 7.35 mm
16_cover_clip_1.stl
16_cover_clip_2.stl
16_cover_clip_3.stl
16_cover_clip_4.stl
