Junshu111/junshu-camera/models/bottom-clips/stl/16_cover_clip_3.stl

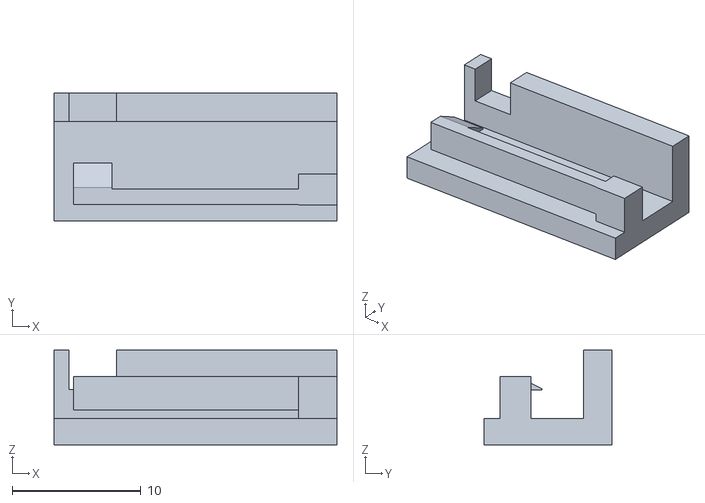
[picture p18: CAD file, 2026-10-31]
models/bottom-clips/stl/16_cover_clip_3.stl
22.0 x 9.95 x 7.35
