Junshu111/junshu-camera/models/exterior-concept-r01/Junshu_Reference_Camera_R01_ViewFixed.FCStd

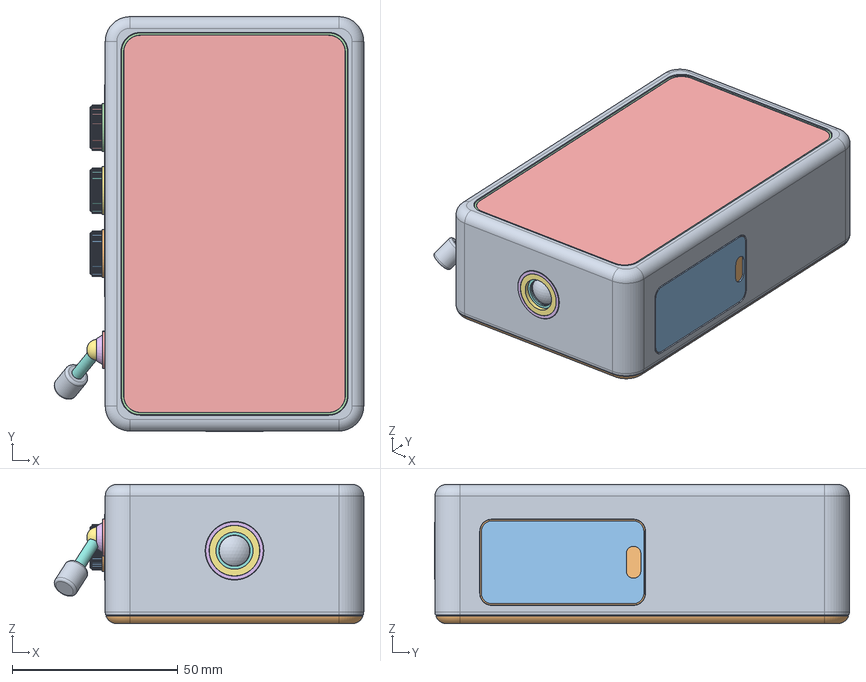
[picture p19: CAD file, 2026-10-31]
models/exterior-concept-r01/Junshu_Reference_Camera_R01_ViewFixed.FCStd
93.4 x 125.2 x 42.0 mm
01 · 米白圆角机身
02 · 底部细缝与底板
03 · 底缝暗线
04 · 屏幕细金属边
05 · 顶部黑色玻璃
06 · 镜头银色边圈
07 · 镜头黑色内圈
08 · 内光圈
09 · 透镜表面
10 · 镜头底层
11 · 三旋钮凹入饰板
12-1 · 旋钮底座
13-1 · 旋钮细齿边
14-1 · 旋钮面
12-2 · 旋钮底座
13-2 · 旋钮细齿边
14-2 · 旋钮面
12-3 · 旋钮底座
13-3 · 旋钮细齿边
14-3 · 旋钮面
15 · 拨杆圆座
16 · 拨杆金属座
17 · 拨杆球头
18 · 金属拨杆
19 · 橙色握柄
20 · 侧盖细缝
21 · 齐平侧盖
22 · 侧盖指扣内凹
23 · 后端竖向开口边
24 · 后端竖向开口内侧
