Junshu111/junshu-camera/models/hood-n3-v1/N3_V1_X2D_PETG_Matte.3mf

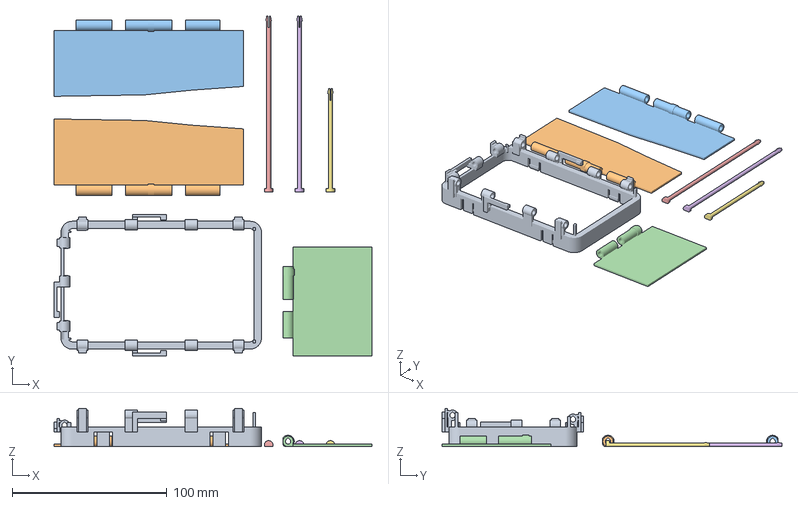
[picture p20: CAD file, 2026-10-31]
models/hood-n3-v1/N3_V1_X2D_PETG_Matte.3mf
205.6 x 220.0 x 24.8 mm
01_N3_clip_on_frame.stl
02_N3_noncontrol_panel.stl
03_N3_control_panel.stl
04_N3_lens_high_panel.stl
05_N3_retaining_axle_L.stl
06_N3_retaining_axle_R.stl
07_N3_retaining_axle_F.stl
