Junshu111/junshu-camera/models/hood-n3-v1/stl/06_N3_retaining_axle_R.stl

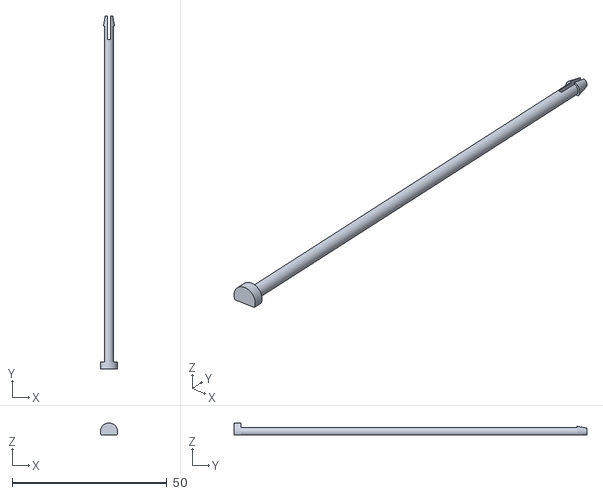
[picture p21: CAD file, 2026-10-31]
models/hood-n3-v1/stl/06_N3_retaining_axle_R.stl
5.60 x 114.0 x 3.90
