Junshu111/junshu-camera/models/lever-v30/01_X2D_PETG_Matte_V30_Lever_Fit_Calibration.3mf

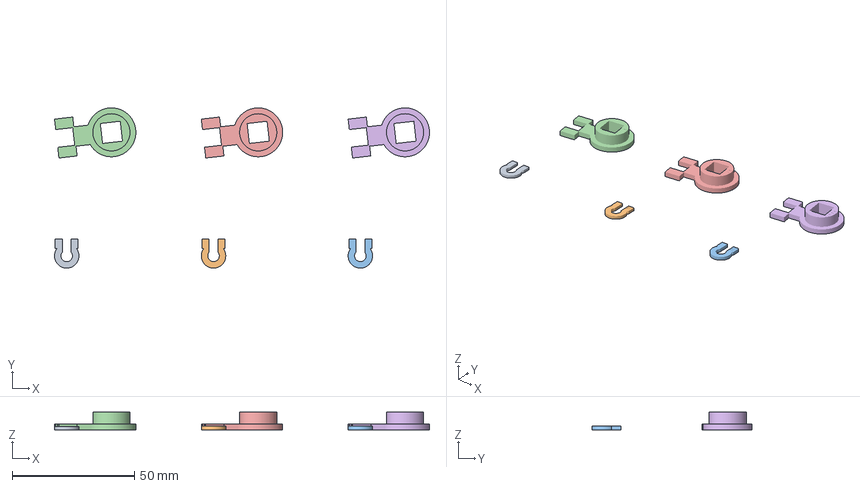
[picture p22: CAD file, 2026-10-31]
models/lever-v30/01_X2D_PETG_Matte_V30_Lever_Fit_Calibration.3mf
153.3 x 65.5 x 7.30 mm
T1_28_keeper_1.40mm.stl
T2_28_keeper_1.52mm.stl
T3_28_keeper_1.64mm.stl
F1_26_rotor_pickup_0.10mm.stl
F2_26_rotor_pickup_0.15mm.stl
F3_26_rotor_pickup_0.20mm.stl
