Junshu111/junshu-camera/models/lever-v30/stl/F1_26_rotor_pickup_0.10mm.stl

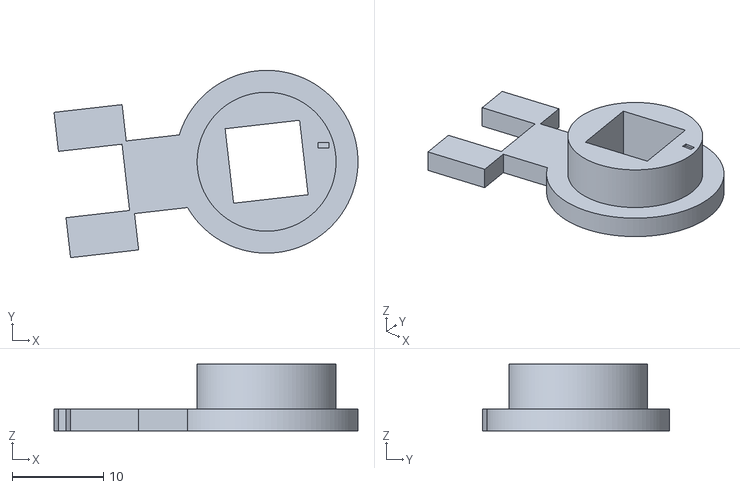
[picture p23: CAD file, 2026-10-31]
models/lever-v30/stl/F1_26_rotor_pickup_0.10mm.stl
33.3 x 20.5 x 7.30
