Junshu111/junshu-camera/models/usb-c-g2/01_X2D_PETG_Matte_USB_C_G2_Corrected_2Plates.3mf

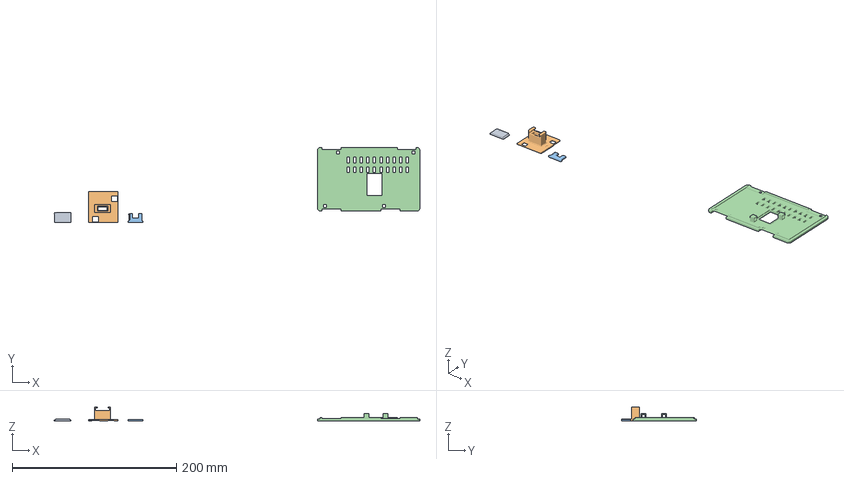
[picture p24: CAD file, 2026-10-31]
models/usb-c-g2/01_X2D_PETG_Matte_USB_C_G2_Corrected_2Plates.3mf
446.2 x 92.0 x 17.4 mm
30_G2_matched_sliding_cover.stl
31_G2_glue_carrier.stl
32_G2_wide_U_rear_stop.stl
04_bottom_lid_recessed_usb-c.stl
