Junshu111/junshu-camera/models/usb-c-g2/stl/31_G2_glue_carrier.stl

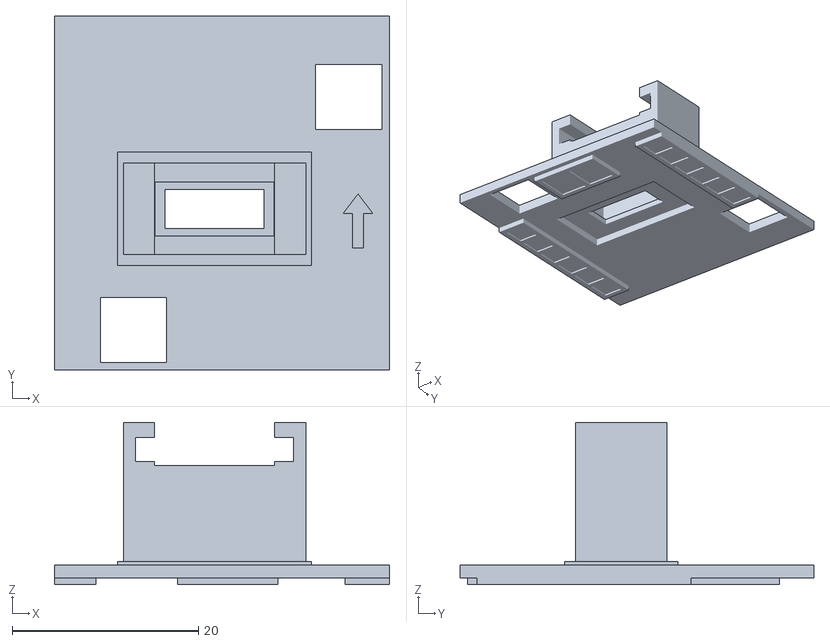
[picture p25: CAD file, 2026-10-31]
models/usb-c-g2/stl/31_G2_glue_carrier.stl
36.0 x 38.0 x 17.4
