Junshu111/junshu-camera/models/battery-v31/stl/09_battery_wrap_v31.stl

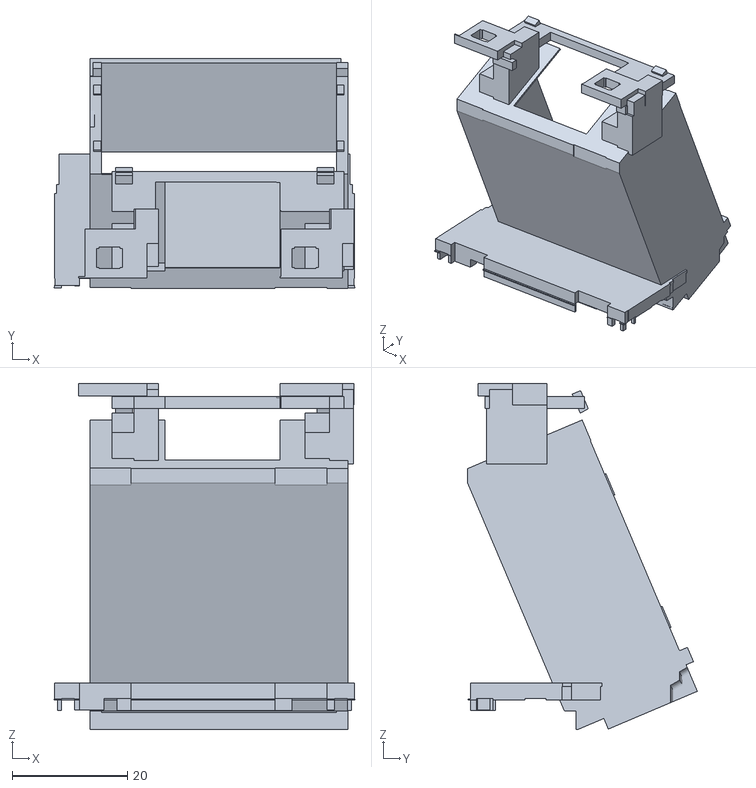
[picture p26: CAD file, 2026-10-31]
models/battery-v31/stl/09_battery_wrap_v31.stl
52.2 x 39.9 x 60.1
