Junshu111/junshu-camera/models/core-20261028/STL/10_battery_anchor_shoe_7.stl

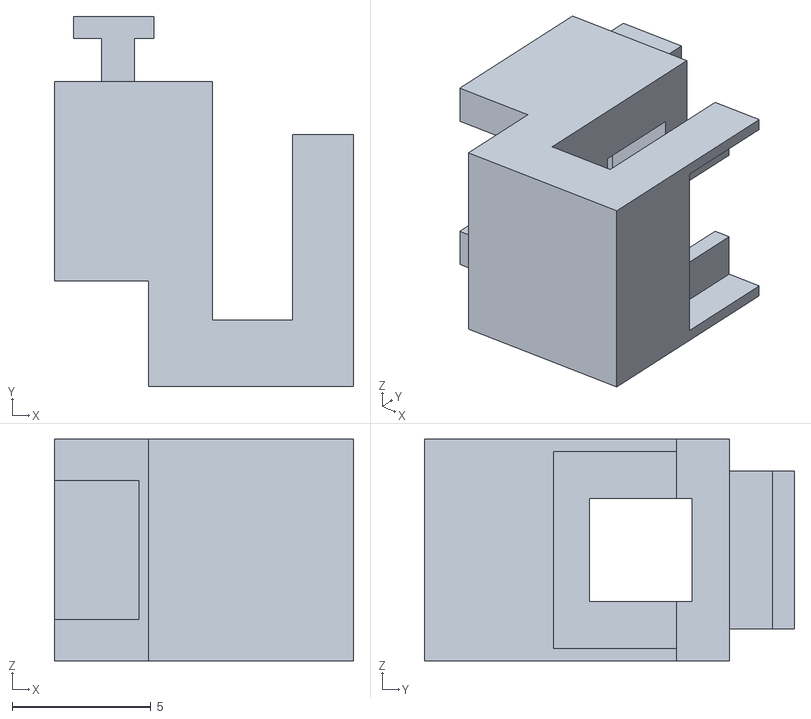
[picture p27: CAD file, 2026-10-31]
models/core-20261028/STL/10_battery_anchor_shoe_7.stl
10.8 x 13.4 x 8.00
