Junshu111/junshu-camera/models/hood-n3-v1/stl/07_N3_retaining_axle_F.stl

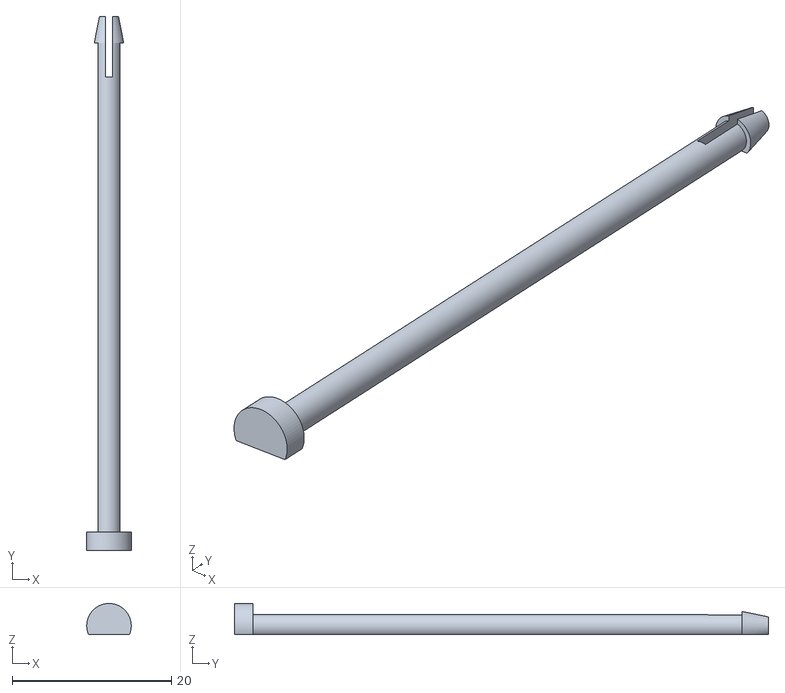
[picture p28: CAD file, 2026-10-31]
models/hood-n3-v1/stl/07_N3_retaining_axle_F.stl
5.60 x 67.0 x 3.90
