Junshu111/junshu-camera/models/lever-v30/stl/T3_28_keeper_1.64mm.stl

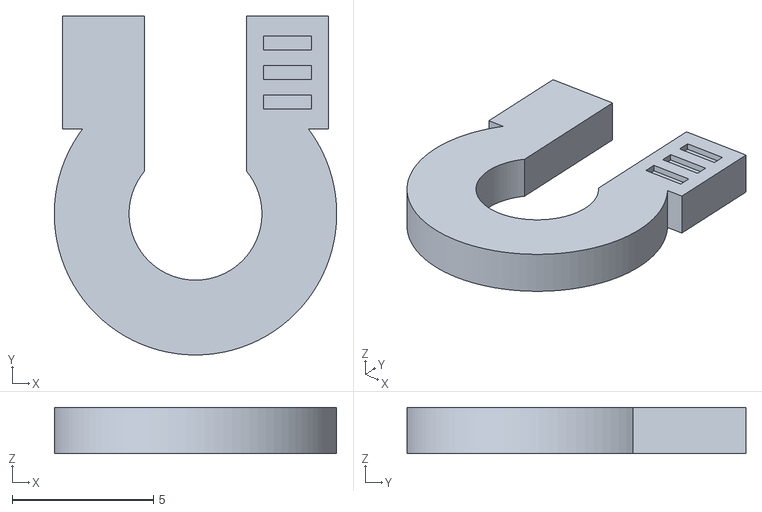
[picture p29: CAD file, 2026-10-31]
models/lever-v30/stl/T3_28_keeper_1.64mm.stl
10.0 x 12.0 x 1.64
