Junshu111/junshu-camera/models/usb-c-g2/stl/04_bottom_lid_recessed_usb-c.stl

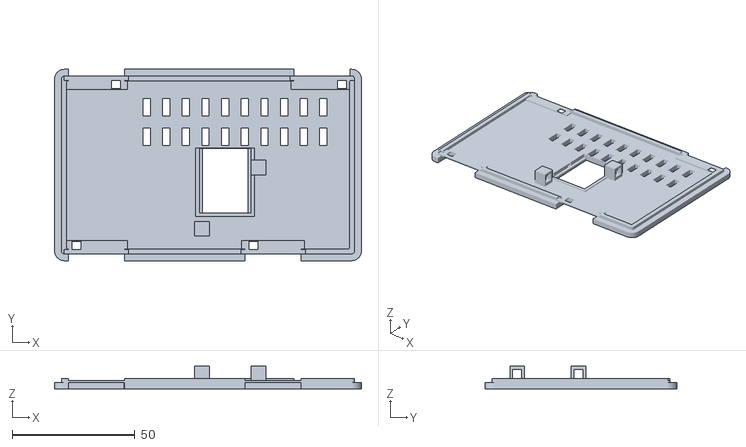
[picture p30: CAD file, 2026-10-31]
models/usb-c-g2/stl/04_bottom_lid_recessed_usb-c.stl
125.0 x 78.0 x 9.30
