Junshu111/junshu-camera/models/core-20261028/STL/14_pi_clip_2.stl

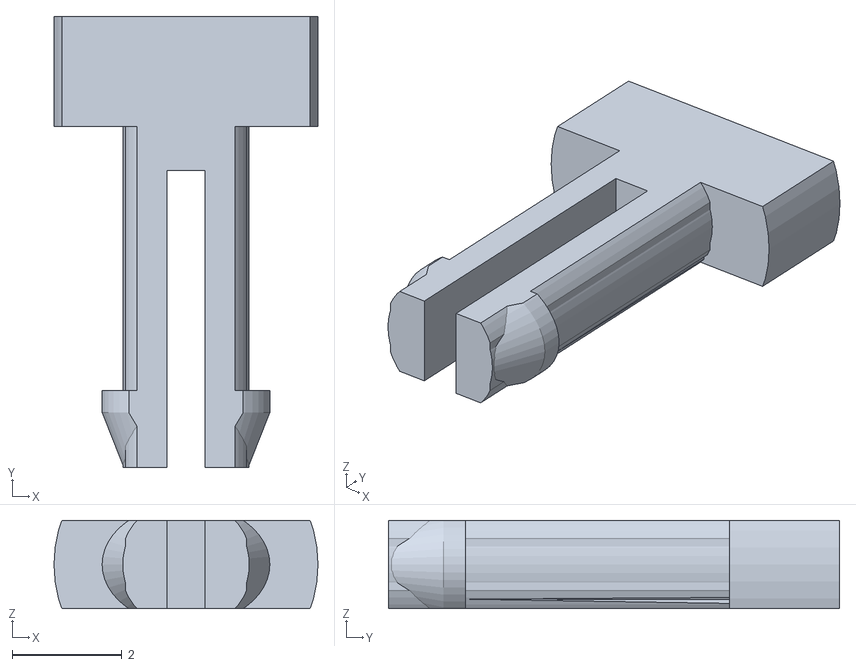
[picture p31: CAD file, 2026-10-31]
models/core-20261028/STL/14_pi_clip_2.stl
4.80 x 8.20 x 1.60
