Junshu111/junshu-camera/models/hood-n3-v1/stl/03_N3_control_panel.stl

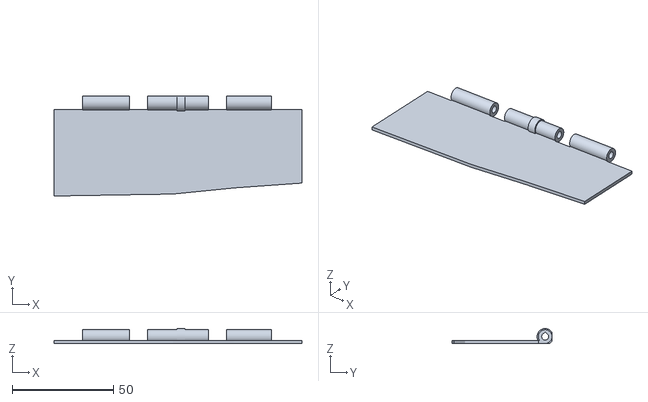
[picture p32: CAD file, 2026-10-31]
models/hood-n3-v1/stl/03_N3_control_panel.stl
122.4 x 49.4 x 7.40
