Junshu111/junshu-camera/models/lever-v30/stl/T2_28_keeper_1.52mm.stl

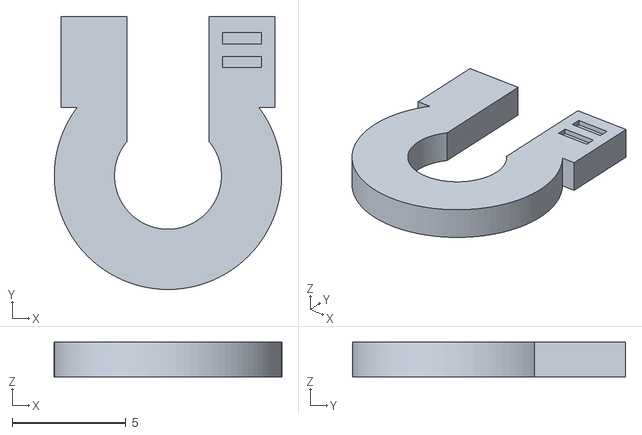
[picture p33: CAD file, 2026-10-31]
models/lever-v30/stl/T2_28_keeper_1.52mm.stl
10.0 x 12.0 x 1.52
