Junshu111/junshu-camera/models/usb-c-g2/stl/30_G2_matched_sliding_cover.stl

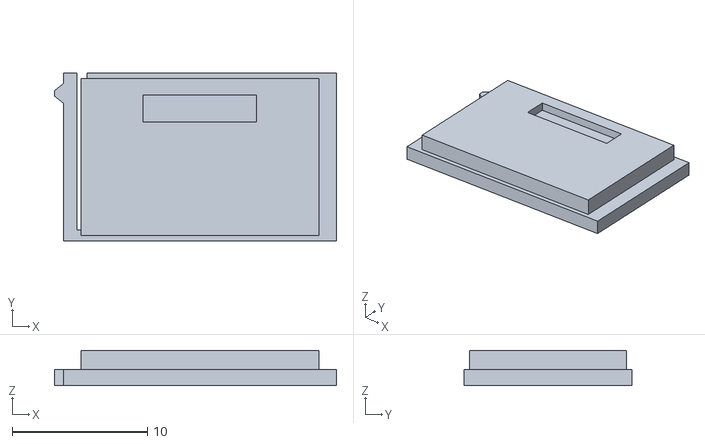
[picture p34: CAD file, 2026-10-31]
models/usb-c-g2/stl/30_G2_matched_sliding_cover.stl
20.9 x 12.4 x 2.60
