Junshu111/junshu-camera/models/core-20261028/STL/32_rear_connector_stop.stl

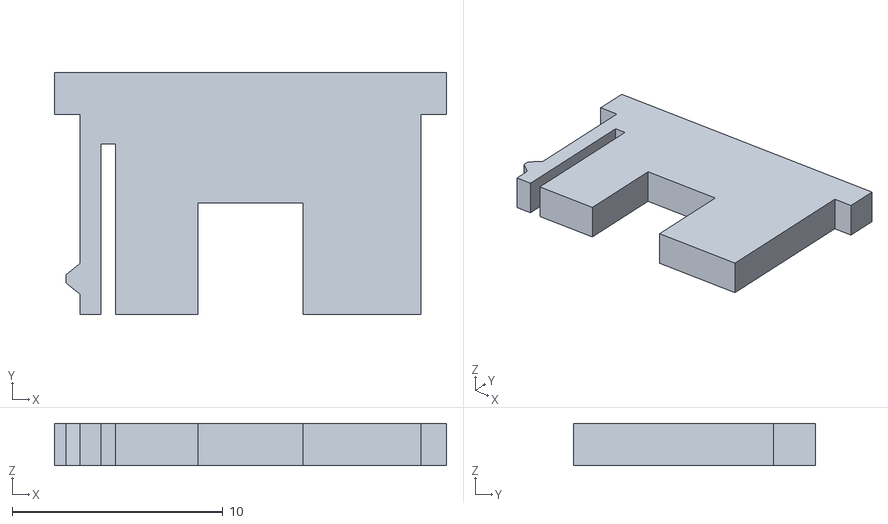
[picture p35: CAD file, 2026-10-31]
models/core-20261028/STL/32_rear_connector_stop.stl
18.6 x 11.5 x 2.00
