Junshu111/junshu-camera/models/usb-c-g2/stl/32_G2_wide_U_rear_stop.stl

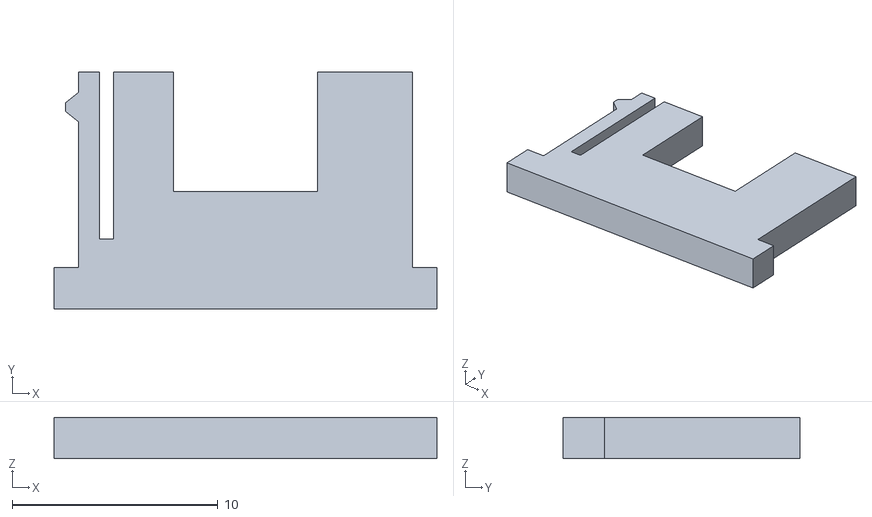
[picture p36: CAD file, 2026-10-31]
models/usb-c-g2/stl/32_G2_wide_U_rear_stop.stl
18.6 x 11.5 x 2.00
