Junshu111/junshu-camera/models/core-20261028/STL/33_carrier_key_left.stl

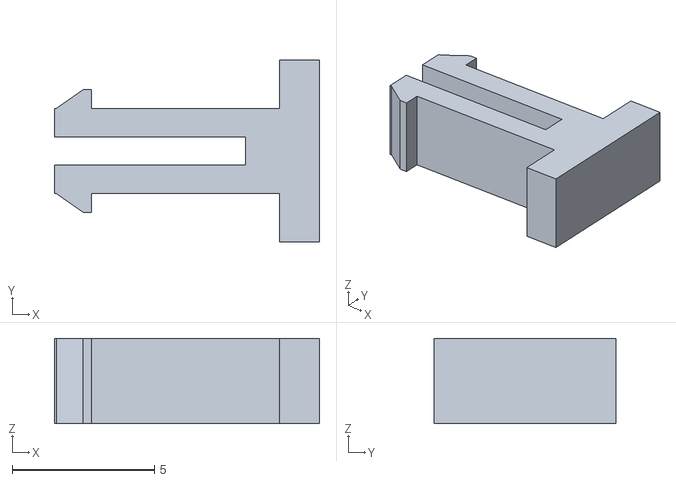
[picture p37: CAD file, 2026-10-31]
models/core-20261028/STL/33_carrier_key_left.stl
9.30 x 6.40 x 3.00
