Junshu111/junshu-camera/models/core-20261028/STL/35_side_shim_0p36.stl

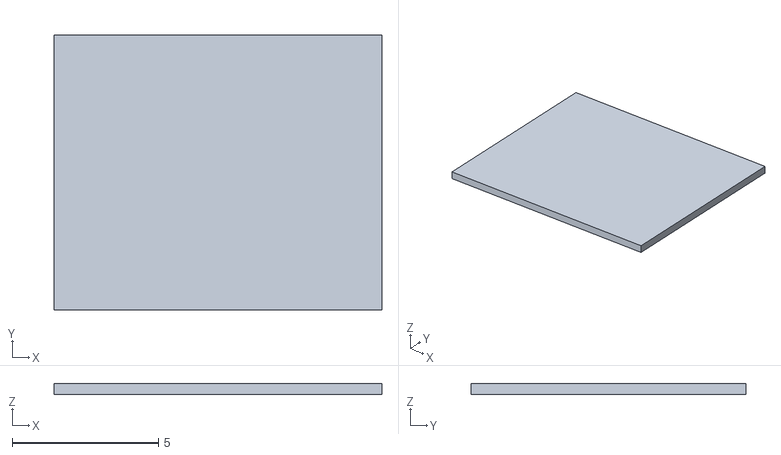
[picture p38: CAD file, 2026-10-31]
models/core-20261028/STL/35_side_shim_0p36.stl
11.2 x 9.40 x 0.36
