Junshu111/junshu-camera/models/hood-n3-v1/stl/01_N3_clip_on_frame.stl

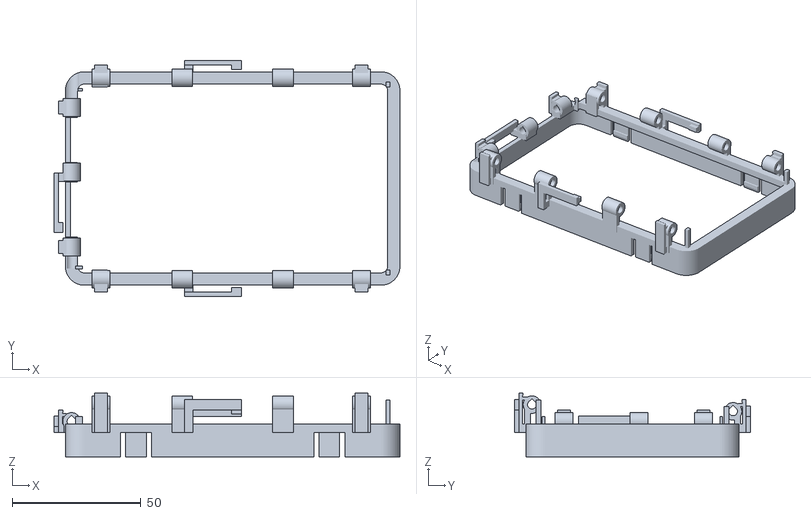
[picture p39: CAD file, 2026-10-31]
models/hood-n3-v1/stl/01_N3_clip_on_frame.stl
134.2 x 91.6 x 24.8
