Junshu111/junshu-camera/models/lever-v30/stl/T1_28_keeper_1.40mm.stl

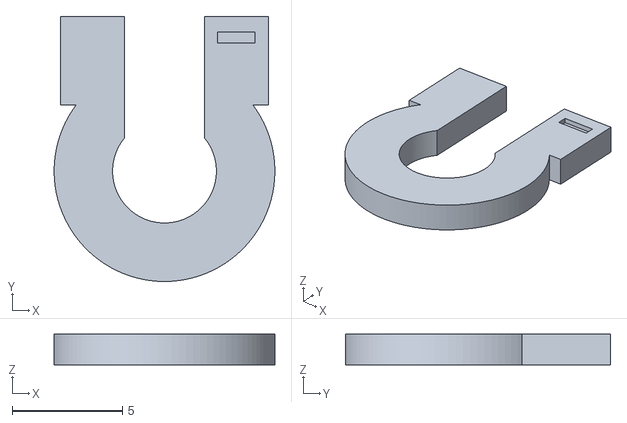
[picture p40: CAD file, 2026-10-31]
models/lever-v30/stl/T1_28_keeper_1.40mm.stl
10.0 x 12.0 x 1.40
