Junshu111/junshu-camera/models/core-20261028/STL/29_concealed_bearing_liner.stl

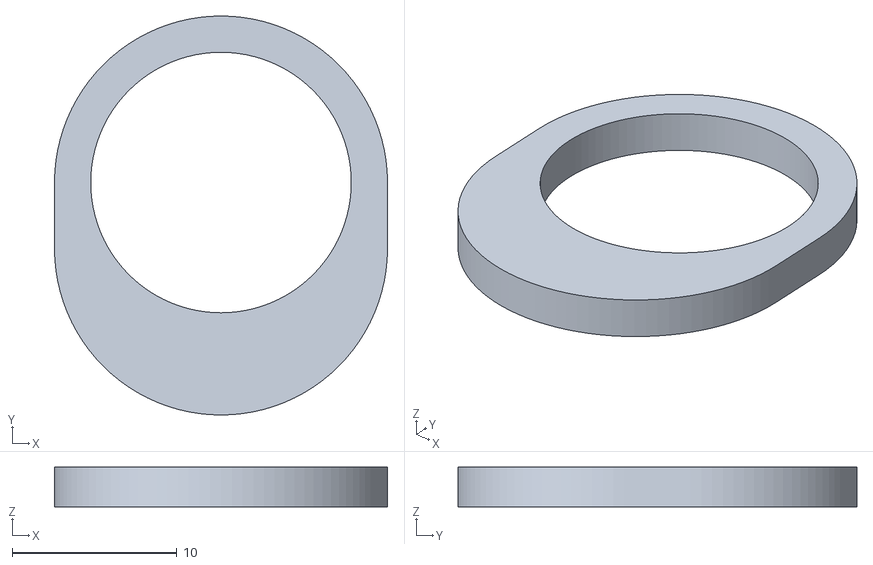
[picture p41: CAD file, 2026-10-31]
models/core-20261028/STL/29_concealed_bearing_liner.stl
20.2 x 24.2 x 2.40
