Junshu111/junshu-camera/models/hood-n3-v1/stl/04_N3_lens_high_panel.stl

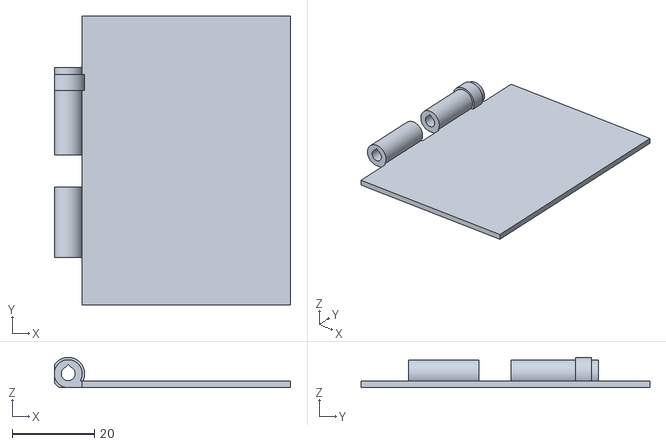
[picture p42: CAD file, 2026-10-31]
models/hood-n3-v1/stl/04_N3_lens_high_panel.stl
57.6 x 70.4 x 7.40
