Junshu111/junshu-camera/models/core-20261028/STL/11_camera_anchor_01_corner_key_v29.stl

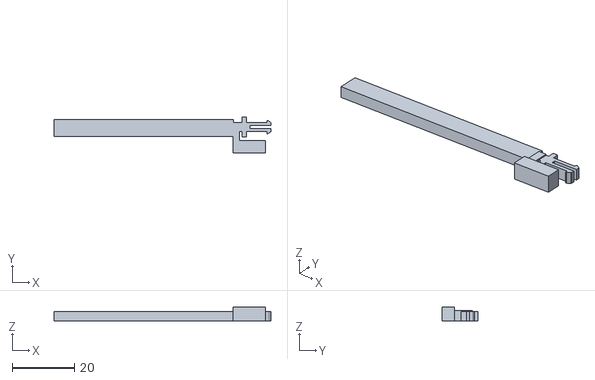
[picture p43: CAD file, 2026-10-31]
models/core-20261028/STL/11_camera_anchor_01_corner_key_v29.stl
69.8 x 11.5 x 4.50
