Junshu111/junshu-camera/models/core-20261028/STL/34_axial_shim_0p68.stl

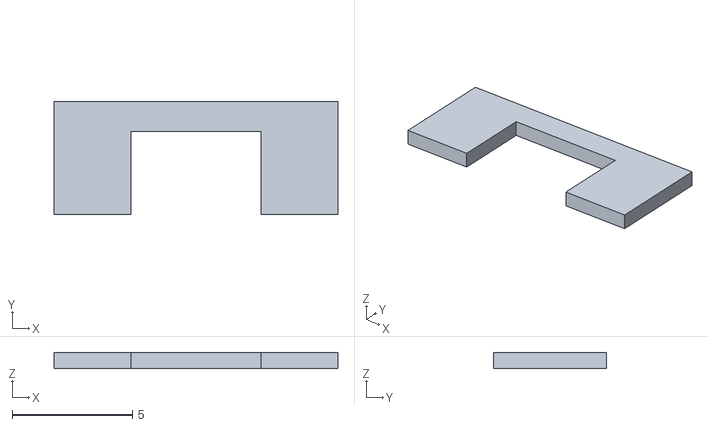
[picture p44: CAD file, 2026-10-31]
models/core-20261028/STL/34_axial_shim_0p68.stl
11.8 x 4.70 x 0.68
