Junshu111/junshu-camera/models/core-20261028/STL/31_usb-c_carrier.stl

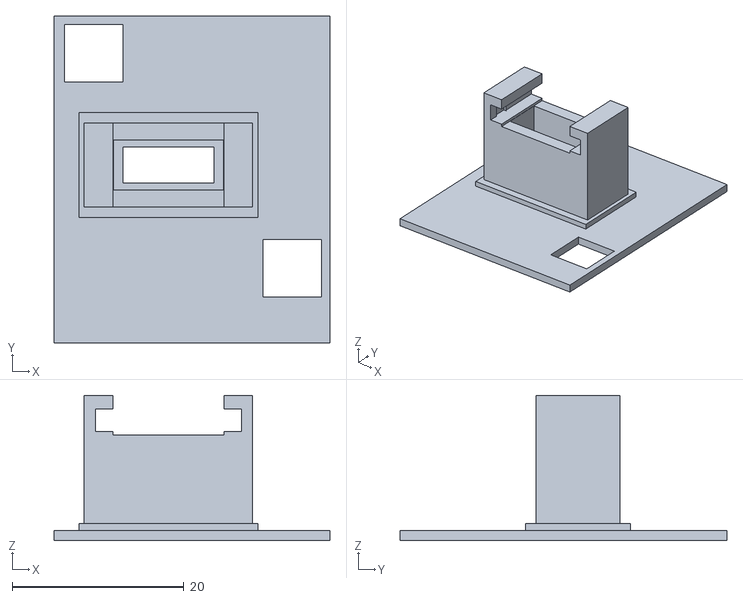
[picture p45: CAD file, 2026-10-31]
models/core-20261028/STL/31_usb-c_carrier.stl
32.1 x 38.0 x 16.9
