Junshu111/junshu-camera/models/core-20261028/STL/05_camera_rear_clamp_forward_v29.stl

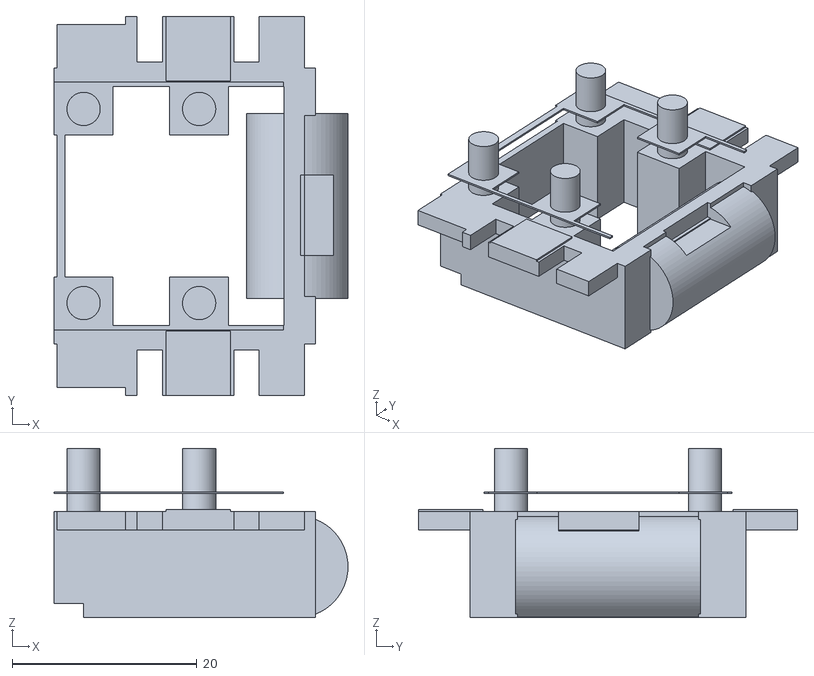
[picture p46: CAD file, 2026-10-31]
models/core-20261028/STL/05_camera_rear_clamp_forward_v29.stl
31.8 x 41.0 x 18.3
