Junshu111/junshu-camera/models/core-20261028/STL/03_pi_carrier_access_reinforced_v28.stl

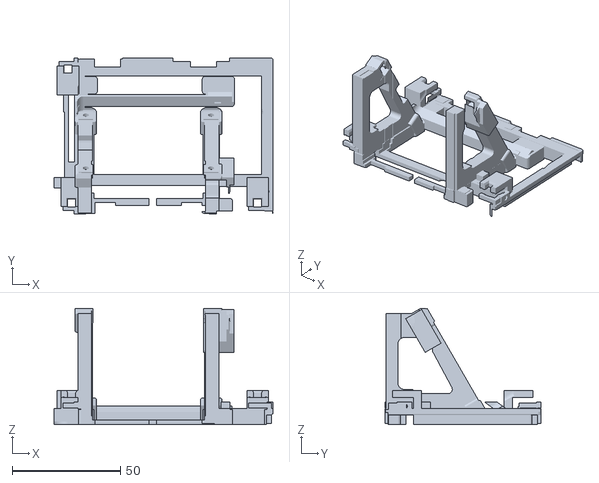
[picture p47: CAD file, 2026-10-31]
models/core-20261028/STL/03_pi_carrier_access_reinforced_v28.stl
101.3 x 72.2 x 53.8
