Junshu111/junshu-camera/models/core-20261028/STL/17_release_pick.stl

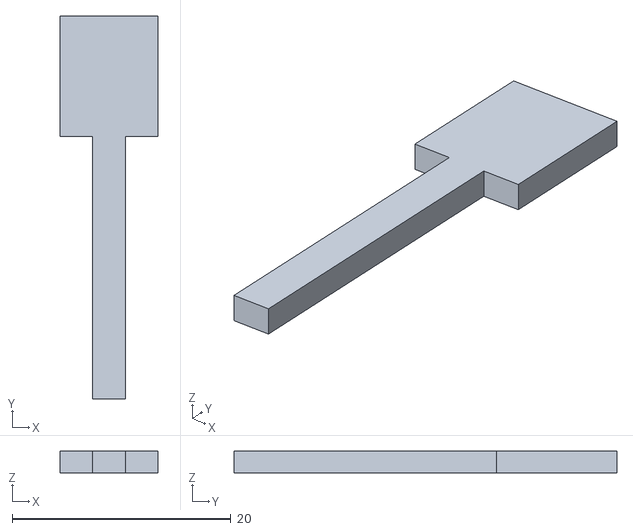
[picture p48: CAD file, 2026-10-31]
models/core-20261028/STL/17_release_pick.stl
9.00 x 35.0 x 2.00
