Junshu111/junshu-camera/models/core-20261028/STL/12_camera_sleeve_56.stl

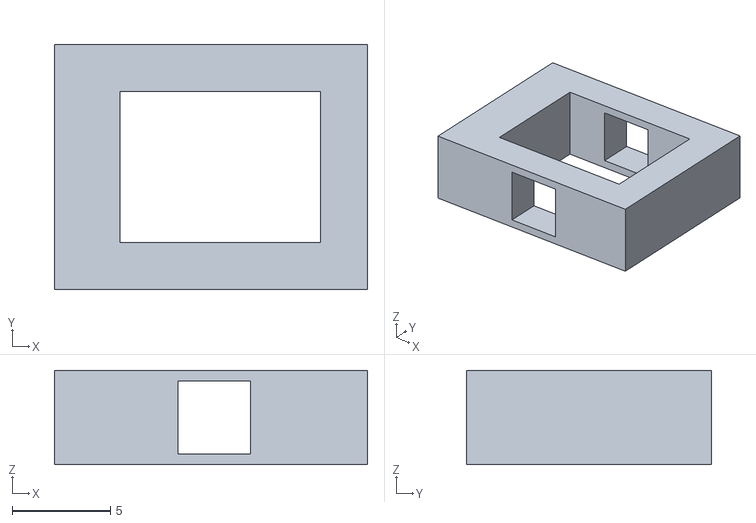
[picture p49: CAD file, 2026-10-31]
models/core-20261028/STL/12_camera_sleeve_56.stl
15.9 x 12.5 x 4.80
