Junshu111/junshu-camera/models/core-20261028/STL/A_down_25_cassette.stl

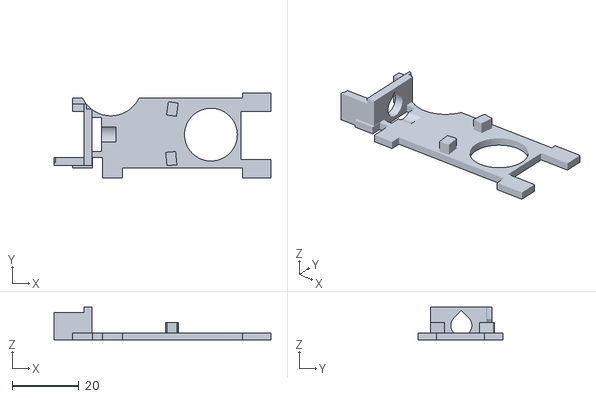
[picture p50: CAD file, 2026-10-31]
models/core-20261028/STL/A_down_25_cassette.stl
65.0 x 25.5 x 9.80
