Junshu111/junshu-camera/models/core-20261028/STL/36_long_lock_05_v28.stl

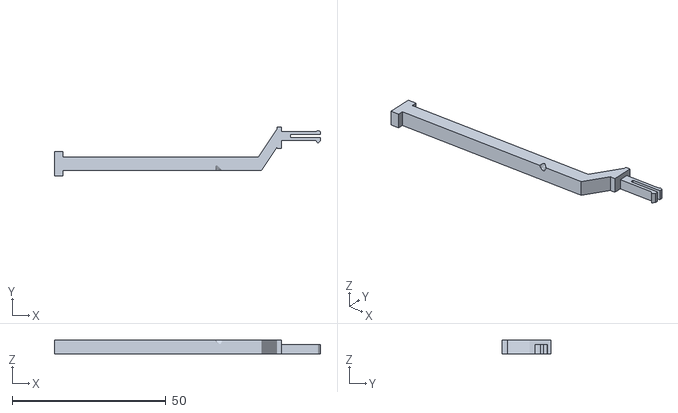
[picture p51: CAD file, 2026-10-31]
models/core-20261028/STL/36_long_lock_05_v28.stl
86.4 x 16.0 x 4.50
