Junshu111/junshu-camera/models/core-20261028/STL/13_camera_key_22.stl

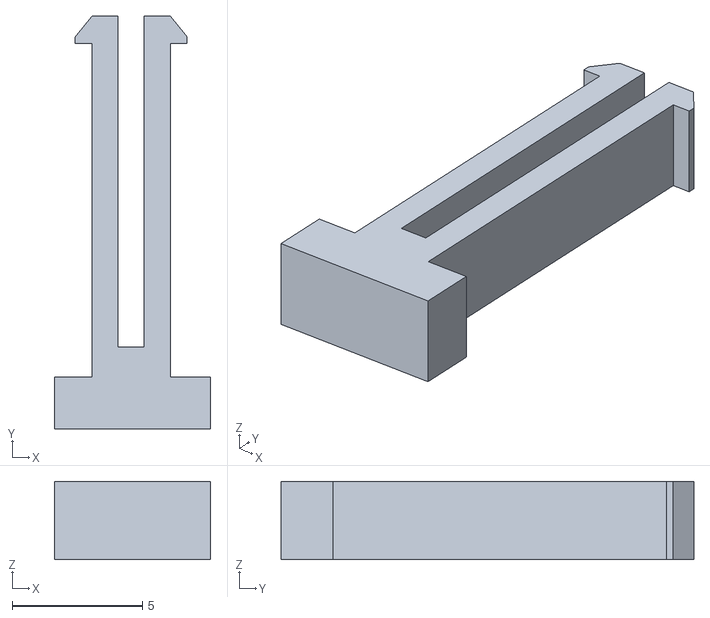
[picture p52: CAD file, 2026-10-31]
models/core-20261028/STL/13_camera_key_22.stl
6.00 x 15.9 x 3.00
