Junshu111/junshu-camera/models/core-20261028/STL/09_battery_cradle_open_end_v28.stl

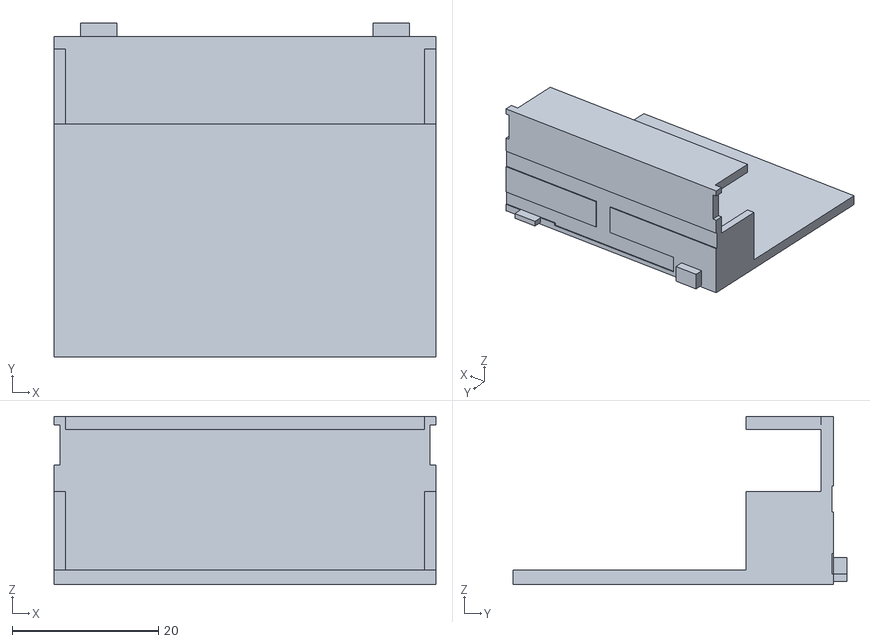
[picture p53: CAD file, 2026-10-31]
models/core-20261028/STL/09_battery_cradle_open_end_v28.stl
52.2 x 45.6 x 23.0
