Junshu111/junshu-camera/models/core-20261028/STL/02_screen_retainer.stl

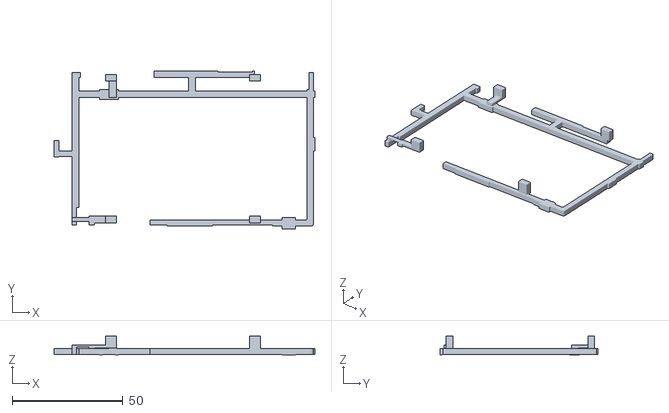
[picture p54: CAD file, 2026-10-31]
models/core-20261028/STL/02_screen_retainer.stl
117.8 x 71.2 x 8.35
