Junshu111/junshu-camera/models/core-20261028/STL/07_battery_bridge_side_entry_v28.stl

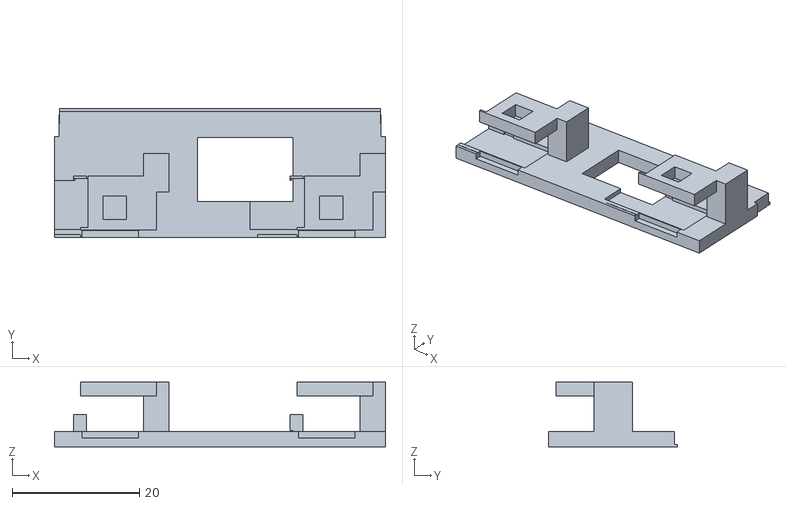
[picture p55: CAD file, 2026-10-31]
models/core-20261028/STL/07_battery_bridge_side_entry_v28.stl
52.0 x 20.3 x 10.1
