Junshu111/junshu-camera/models/core-20261028/STL/06_camera_front_frame_forward_v29.stl

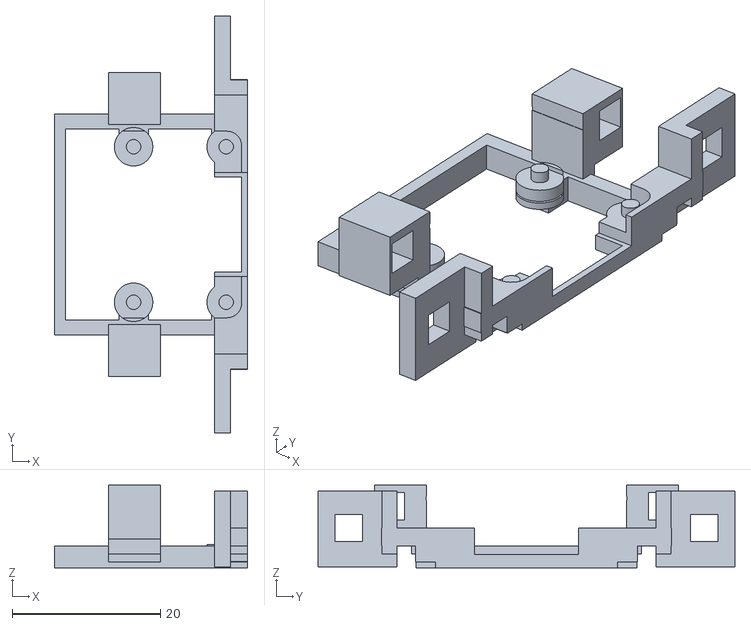
[picture p56: CAD file, 2026-10-31]
models/core-20261028/STL/06_camera_front_frame_forward_v29.stl
26.1 x 56.3 x 11.2
