Junshu111/junshu-camera/models/core-20261028/STL/36_long_lock_03_v28.stl

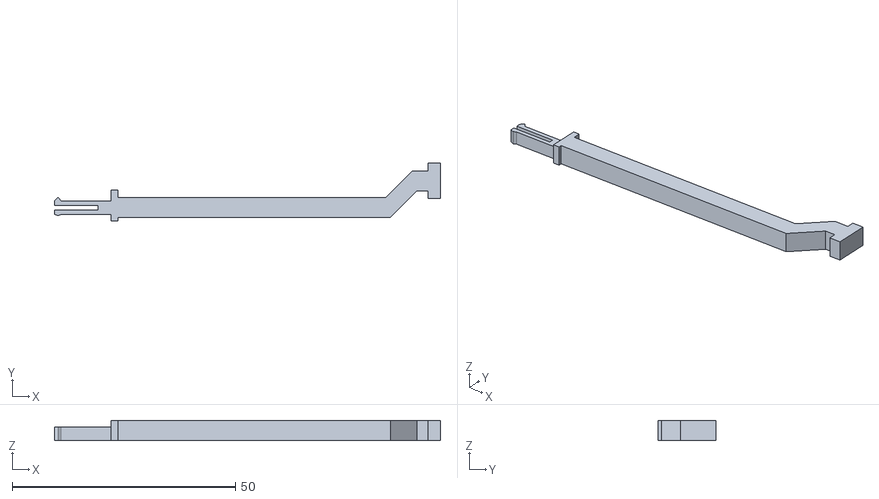
[picture p57: CAD file, 2026-10-31]
models/core-20261028/STL/36_long_lock_03_v28.stl
86.4 x 13.0 x 4.50
