Junshu111/junshu-camera/models/core-20261028/STL/10_camera_anchor_01_access_v29.stl

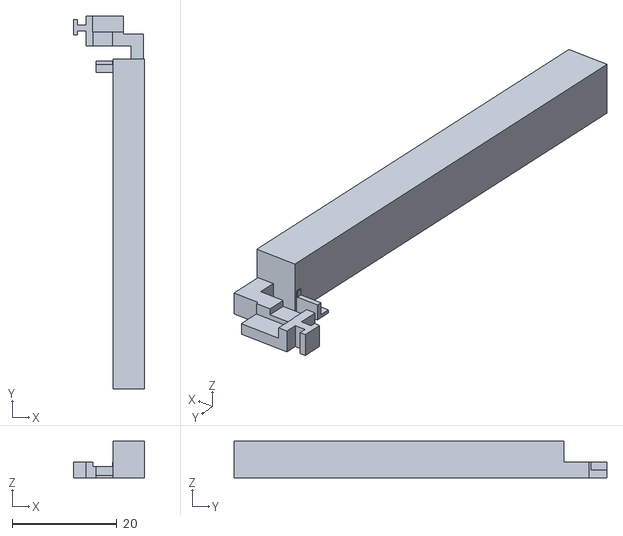
[picture p58: CAD file, 2026-10-31]
models/core-20261028/STL/10_camera_anchor_01_access_v29.stl
13.6 x 71.2 x 7.00
