Junshu111/junshu-camera/models/core-20261028/STL/27_rearward_handle_b.stl

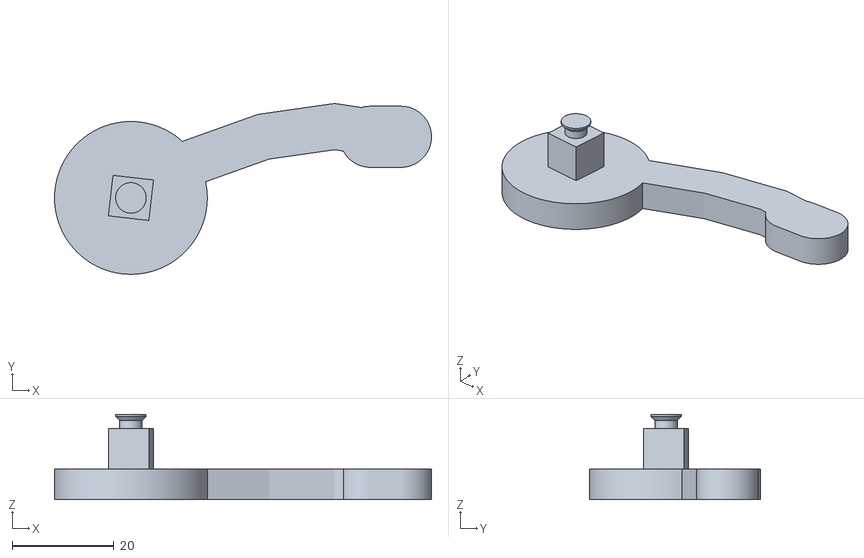
[picture p59: CAD file, 2026-10-31]
models/core-20261028/STL/27_rearward_handle_b.stl
74.0 x 33.5 x 16.7
