Junshu111/junshu-camera/models/core-20261028/STL/27_rearward_handle_c.stl

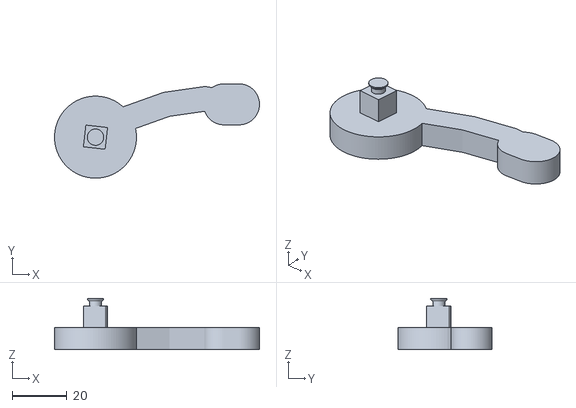
[picture p60: CAD file, 2026-10-31]
models/core-20261028/STL/27_rearward_handle_c.stl
75.0 x 34.5 x 18.7
