Junshu111/junshu-camera/models/core-20261028/STL/34_rigid_cassette_withdrawal_key.stl

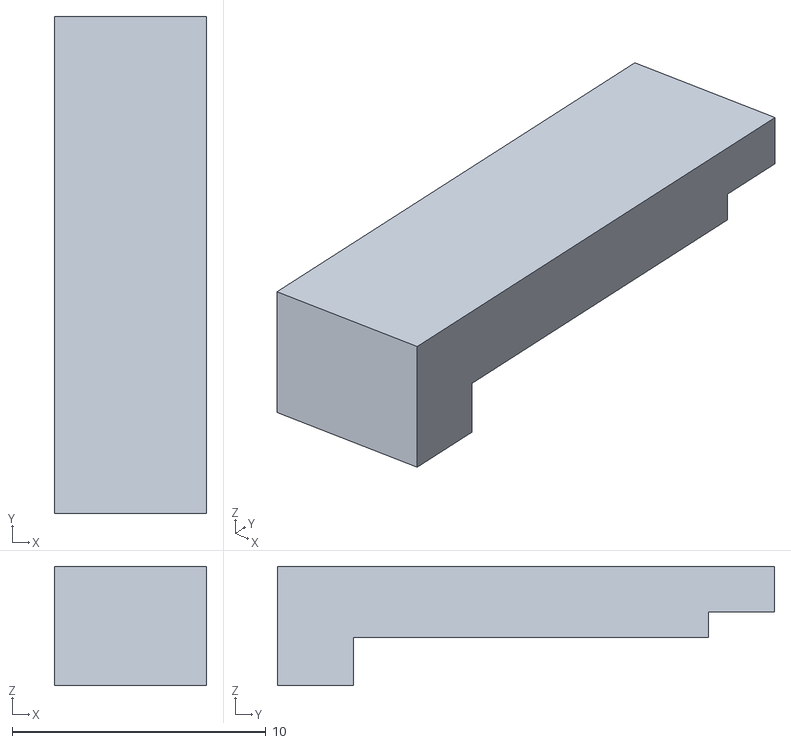
[picture p61: CAD file, 2026-10-31]
models/core-20261028/STL/34_rigid_cassette_withdrawal_key.stl
6.00 x 19.6 x 4.70
