Junshu111/junshu-camera/(list of files, cad)

Other CAD files:
models/bottom-clips/stl/16_cover_clip_2.stl
models/exterior-concept-r01/Junshu_Reference_Camera_R01.step
models/bottom-clips/stl/16_cover_clip_1.stl
models/hood-n3-v1/stl/02_N3_noncontrol_panel.stl
models/lever-v30/stl/F3_26_rotor_pickup_0.20mm.stl
models/hood-n3-v1/stl/05_N3_retaining_axle_L.stl
models/lever-v30/stl/F2_26_rotor_pickup_0.15mm.stl
models/core-20261028/STL/11_battery_anchor_key_6.stl
models/core-20261028/STL/11_anchor_key_02.stl
models/core-20261028/STL/10_anchor_shoe_04.stl
models/core-20261028/STL/30_sliding_dust_cover.stl
models/core-20261028/STL/16_cover_clip_2.stl
models/core-20261028/STL/14_pi_clip_3.stl
models/core-20261028/STL/10_anchor_shoe_02.stl
models/core-20261028/STL/A_down_26_rotor.stl
models/core-20261028/STL/10_anchor_shoe_03.stl
models/core-20261028/STL/14_pi_clip_4.stl
models/core-20261028/STL/14_pi_clip_1.stl
models/core-20261028/STL/12_camera_sleeve_22.stl
models/core-20261028/STL/13_camera_key_56.stl
models/core-20261028/STL/28_hidden_pivot_keeper.stl
models/core-20261028/STL/33_carrier_key_right.stl
models/core-20261028/STL/10_anchor_shoe_05.stl
models/core-20261028/STL/11_battery_anchor_key_7.stl
models/core-20261028/STL/10_battery_anchor_shoe_6.stl
models/core-20261028/STL/16_cover_clip_1.stl
models/core-20261028/STL/35_independent_button_washer_seat.stl
models/core-20261028/source/当前完整装配.blend
models/hood-n3-v1/source/N3-V1-装配模型.blend
models/usb-c-g2/source/G2-方向修正与原底板.blend
