Junshu111/junshu-camera/models/hood-n3-v1/guides/N3-V1-打印与逐步安装.html

自制相机 / N3-V1 / 可打印遮光斗

# N3 长高肩遮光斗，七件一盘打印。

三块整板直接收成屏幕盖，套框装到现有 V27／V28 共用机壳上缘。此版已加入真实铰链、打印防退轴、开盖止挡和一体定位弹舌。

X2D · 0.4 mmPETG Matte原打印参数无补片无需重打主壳

打开打印 3MF

本机实际切片估算：约4小时03分、68.6g（含支撑及brim）；支撑约6.59g。估算不等于实际耗材与时间。

最终制造模型展开与闭合

## 沿用你之前的打印规格

X2D 0.4 mm、PETG Matte、Textured PEI；层高0.16 mm、首层0.20 mm、4墙、20% gyroid、5 mm外brim。

普通自动 Snug 支撑35°，上下Z间隙0.24 mm、XY间隙0.35 mm，界面顶3／底2层、间距0.5 mm；非仅热床支撑、圆弧拟合关闭。完整预设已嵌入工程并切片、重开回读核对。

用“打开为工程”，保持比例100%和已设置摆向。不要因为板片平放就关闭全盘支撑：01套框需要支撑。预设名称可能仍显示V23，属于继承的成功工艺名称，几何模型为N3-V1。

真实铰链使闭合叠层高于早期薄板概念图；最终外形以本页实际网格图为准。展开镜头端最高约58.5 mm（相对机壳顶面），主板1.6 mm厚，闭合盖面距机壳顶面约14.2 mm；含止挡的整体最高约15.3 mm。

## 七件各打印一件

编号 | 零件 | 数量 | 打印包围尺寸mm | 独立STL
01 | 卡装套框 | 1 | 134.2 × 91.6 × 24.8 | 01_N3_clip_on_frame.stl
02 | 无控件侧长肩板 | 1 | 122.4 × 49.4 × 7.4 | 02_N3_noncontrol_panel.stl
03 | 控件侧长肩板 | 1 | 122.4 × 49.4 × 7.4 | 03_N3_control_panel.stl
04 | 镜头侧高板 | 1 | 57.6 × 70.4 × 7.4 | 04_N3_lens_high_panel.stl
05 | 长铰轴 | 1 | 5.6 × 114.0 × 3.9 | 05_N3_retaining_axle_L.stl
06 | 长铰轴 | 1 | 5.6 × 114.0 × 3.9 | 06_N3_retaining_axle_R.stl
07 | 短铰轴 | 1 | 5.6 × 67.0 × 3.9 | 07_N3_retaining_axle_F.stl

下载零件CSV · 查看原生装配模型

STL已包含推荐打印摆向。02／03按盘中编号分别收好；05／06两根长轴同规格，07是短轴。套框夹爪抱塑料侧壁，边框承托不压玻璃；没有新增金属紧固件。

## 按这十步打印、装配与收合

先在桌面装好遮光斗，再套到相机上。图片均来自本次真实打印网格，点击可以放大；橙色为镜头高板、深绿为无控件侧、青绿为控件侧，金色为铰轴。

01

### 打开工程，打印这一盘

用 Bambu Studio 选择打开为工程：N3_V1_X2D_PETG_Matte.3mf。七件各一件都在同一盘，已有机壳不用重打。

保持比例100%及现有摆向；套框倒置、板片大面贴床、铰轴平放均已设好。02／03按图中编号分开，05／06同规格可互换，07较短。颜色只用于讲解，实际沿用单一PETG Matte料槽。

打开工程，打印这一盘

02

### 清理支撑，先保留细结构

本次实际切片中，支撑集中在01套框，约6.59g；另外六件没有生成支撑。保持工程的自动支撑开启。

只去掉切片预览中标为支撑的材料。四个夹爪、长条定位弹舌、圆管铰链和竖向止挡都属于模型，不能剪掉。清理轴孔和槽内残料，保留板片完整边缘。

清理支撑，先保留细结构

03

### 先在桌面认清七件朝向

先组遮光斗，相机暂时放旁边。套框有短边铰链的一端是镜头端；另一短边敞开，对观看端。

02在无控件侧，03在相机拨杆所在的控件侧；03轴线略高。两块侧板都是高肩朝镜头端、低端朝观看端，带铰链凸台的一面朝屏幕。图为爆炸示意，下面按件安装。

先在桌面认清七件朝向

04

### 装02无控件侧板，再插05长轴

把02保持展开竖直，从上方放入套框对应位置，让活动轴节与固定轴节交错，轴孔排成一直线。

05分叉细尾先进入，从镜头端推向观看端。大挡头留在镜头端，细尾从后端露出。让打印时贴床的平面朝上；扶住轴节，推轴头，不掰分叉尾。若孔内残料卡住，先退出清理。

装02无控件侧板，再插05长轴

05

### 装03控件侧板，再插06长轴

在较高的那排长铰链装03，同样保持竖直、高肩朝镜头。带凸轮的轴节要与套框定位弹舌相对。

06仍从镜头端推向观看端，挡头在前、分叉尾在后。两根长轴只各用一根，不需要金属销、螺丝或额外卡圈。

06

### 装04镜头高板，最后插07短轴

04竖在镜头端。它的铰链凸台朝屏幕，较大的圆形凸轮在控件侧半边，和套框前边的弹舌相对；对好后从上方交错轴节。

07分叉细尾先进入，从无控件侧推向控件侧。挡头留在无控件侧，分叉尾露在控件侧。轻转三块板确认能到竖直止挡；定位弹舌会有小幅弹性接触。局部图以长边机构展示相同原理。

装04镜头高板，最后插07短轴

07

### 整件从上方套到原机壳

三块板保持展开。短板对镜头孔这一端，03对拨杆所在一边。让套框四周同时套住机壳上缘，再交替轻压两侧套框。

压在套框的厚边，不要压屏幕、高板自由边或用铰轴当把手。坐到底时由塑料边框承托，四夹爪抱侧壁；检查套框不翘起、玻璃没有受压。平滑侧壁的实际保持力要以本次装机确认。

整件从上方套到原机壳

08

### 合盖①：镜头高板先放下

先把04朝屏幕方向放下，让它落在最下层。此时两侧长板仍竖直。

不要先把长侧板盖住短板；本模型的闭合高度和承托按这个顺序设计。

合盖①：镜头高板先放下

09

### 合盖②：无控件侧整板放下

02整片向内翻，落在中间层。03继续竖着。

这块完整侧板直接承担盖面，没有补片，也没有需要另翻出来的小叶片。

合盖②：无控件侧整板放下

10

### 合盖③：控件侧整板最后盖上

最后把03向内盖在上层，两侧在中央直接搭接，覆盖屏幕。盖面会保留实际搭接线和层差。

打开反过来：先抬03 → 再抬02 → 最后立起04，到竖直止挡为止。拆整套时先展开，扶住套框释放侧边夹爪，交替向上提框；不要撬玻璃或扯高板。

合盖③：控件侧整板最后盖上

## 第一次装好后，检查这四件事

1. 套框落在塑料边框上，四侧不翘；玻璃与屏幕显示区域没有受压。
2. 三根轴尾都从最后一个固定轴节露出，轴头不会继续穿过轴孔，转板时轴不自行退出。
3. 三块板能立到止挡，在正常持机姿态下能保持展开；轻合时依次到位，不靠硬压越过碰撞。
4. 03最后盖上后覆盖完整屏幕，打开仍按03→02→04。若夹爪松动、定位不足或孔过紧，记录对应位置再调尺寸，不整体缩放。

数字检查：7件单连通闭合；223个开合姿态、逐件装板/插轴和整件套壳路径采样无未解释刚性干涉；8190个屏幕投影点覆盖。弹舌、夹爪和轴尾的预期弹性接触另计。工程7件网格索引/三角形、摆向与预设回读匹配，切片盘无警告。实物卡紧力、开合手感、PETG保持力与寿命、屏幕防护仍待这次装机反馈。

仅新增遮光斗文件，没有改E主壳或内部结构、连接打印机、操作Pi或删除旧版本。原壳体参考ioannis「BTT TFT50 Raspberry Pi 3B+ box」，沿用BY-NC-SA署名。2026-10-27。

回到顶部 ↑

关闭 ×
