Junshu111/junshu-camera/CHANGELOG.md

# 版本记录

## 2026-11-01 · 网页复制与交互修复

- 首页和获取项目页增加同步复制、Clipboard API 与手动文本框后备，保留完整多行提示词。
- 成功提示显示在按钮及其旁边；权限长时间未返回时恢复操作并提供手动复制。
- 网页脚本随内容更新缓存版本，避免继续使用旧复制逻辑。
- 增加真实浏览器复制及整站交互回归脚本；普通阅读仍不需要 Node.js。

## 2026-10-31 · 离线阅读

- 经用户确认公开中文 PDF 手册，正文同步当前网页，AI 两步入口置于第二页。
- 首页最下面和页脚新增 PDF 下载链接。
- 频道视频制作素材仍不上传。

## 2026-10-31 · 名称统一

- 网页、AI 提示词、教程、工作流交接及许可署名统一为“自制相机”。
- 原网址及软件历史兼容标识保留；应用归档只更新说明文字与校验，不改变程序。
- PDF 继续不上传。

## 完整技术参考开源 · 2026-10-31

- 补齐 New Cam 1.0 应用、启动主题、冻结归档及设备限定支撑源码。
- 提供73个STL、6份3MF、3份Blender装配及FreeCAD／STEP概念源，明确V31／G2替换和V30选档关系。
- 补充需求与决策参考、来源校验、硬件入口、自有代码MIT与模型图文CC BY 4.0许可。
- 新手两步入口保持先建立工作台；软件和模型供参考及适配，PDF和视频制作资料不随发布。

## 新手协作入口 · 2026-10-31

- 两步复制后先展示分工图，选择新项目或当前项目，再准备 00＋A—F 七个对话。
- 补充七角色启动交接、真实就绪核对和个人进度模板。
- 自动创建不可用时逐步手动引导；支持单对话、离线和无 Python 的后备。
- 说明当前发行内容与尚缺的软件、模型，避免把工作台准备写成相机已搭建。

## 屏幕适配修复 · 2026-10-31

- 整页最大宽度 1600px、正文最大宽度 1320px；超宽屏居中留白。
- 修复详情区留白随屏幕扩大、挤压文字成为竖排的问题。
- 检查 320 至 5120px 的 18 种宽度，保留手机单栏、平板与桌面分栏。
- 样式链接增加内容版本号，使更新后加载对应的新样式。

## 网页发布更新 · 2026-10-31

- 首页底部与 AI 起步页统一采用线描两步设计。
- 先发 GitHub 链接，再发完整提示词；加入分别复制与手动复制降级。
- 保留桌面和手机阅读布局，PDF 不随本次发布。

## 第1版 · 2026-10-30

- 按已确认的海报重黑排版完成20个中文网页。
- 补全16章正文、完成检查、排错与事实来源。
- 增加采购和接线核对表、可保存勾选、章节搜索。
- 写入正式仓库地址和可复制的AI起步提示词。
- 保留软件、结构与实机验证之间的边界。
- 按项目维护者要求排除PDF，等待单独确认。
