Junshu111/junshu-camera/software/tools/camera_v1_remote.py

#!/usr/bin/env python3
"""Mac-side New Cam 1.0 probe, staged install, verify and independent rollback."""
import argparse
import base64
import hashlib
import importlib.util
import json
from pathlib import Path
import re
import subprocess
import sys

ROOT = Path(__file__).absolute().parents[1]
TOOLS = Path(__file__).absolute().parent
APP_PREFIX = 'junshu-camera-pi-1.0.0'
BOOT_PREFIX = 'junshu-camera-boot-1.0.0'
REPORTS = ROOT/'qa/newcam-1.0/device-reports'


def _load(path, name):
    spec = importlib.util.spec_from_file_location(name, path)
    module = importlib.util.module_from_spec(spec)
    spec.loader.exec_module(module)
    return module


network = _load(TOOLS/'pi_next_remote.py', 'v1_network')
payload = _load(TOOLS/'camera_v1_boot_payload.py', 'v1_payload')
checker = _load(ROOT/'pi-camera-1.0/check_package.py', 'v1_checker_remote')


class RemoteActionError(ValueError):
    def __init__(self, message, report):
        super().__init__(message)
        self.report = report


def sha(data):
    return hashlib.sha256(data).hexdigest()
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
