Junshu111/junshu-camera/(commit log)

2026-10-31 Publish approved Chinese camera guide with two-step AI setup
    [chapter-04-table.csv, chapter-10-table.csv]
2026-10-31 Publish camera software, printable models and complete open workflow references
    [01_N3_clip_on_frame.stl, 01_X2D_PETG_Matte_Bottom_Lid_4_Clips_Current_20261028.3mf, 01_X2D_PETG_Matte_Current_Complete_20261028.3mf, 01_X2D_PETG_Matte_USB_C_G2_Corrected_2Plates.3mf, 01_X2D_PETG_Matte_V30_Lever_Fit_Calibration.3mf, 01_X2D_PETG_Matte_V31_Battery_48x40x20.3mf, 01_main_body_106mm.stl, 02_N3_noncontrol_panel.stl]
2026-10-31 Use 自制相机 throughout public guide and workflow materials
2026-10-31 Fix copy buttons with browser fallbacks and visible feedback
